UC-Aerospace/Hybrid26_Radio/01 Link Margin/plots/link_margin_heatmap.png

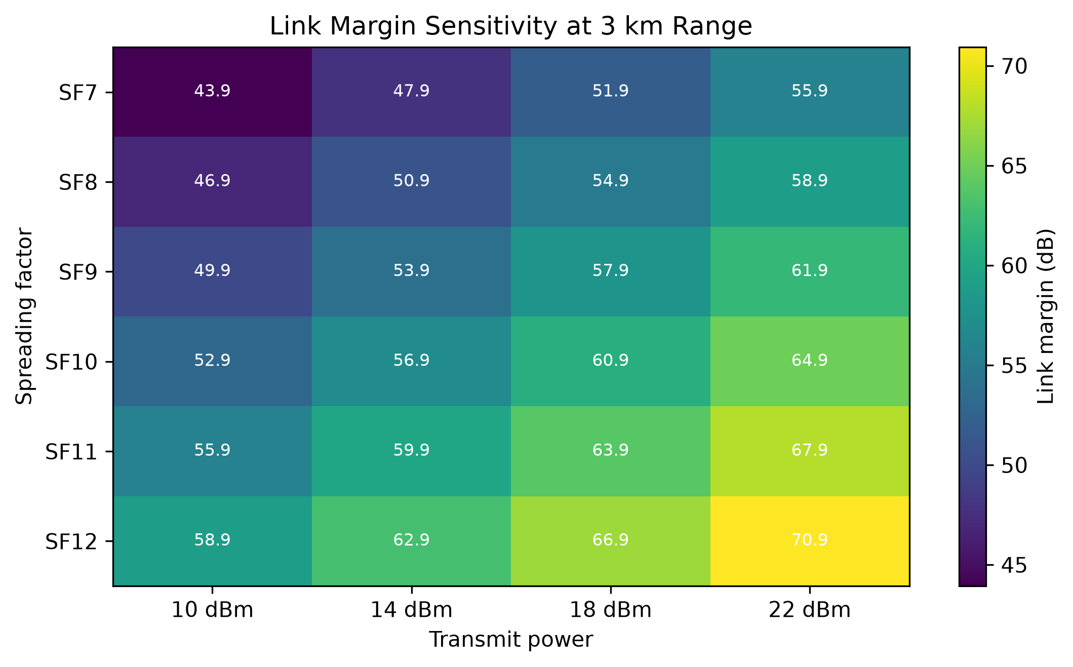
01 Link Margin/plots/link_margin_heatmap.png
