UC-Aerospace/Hybrid26_Radio/01 Link Margin/plots/flight_profile.png

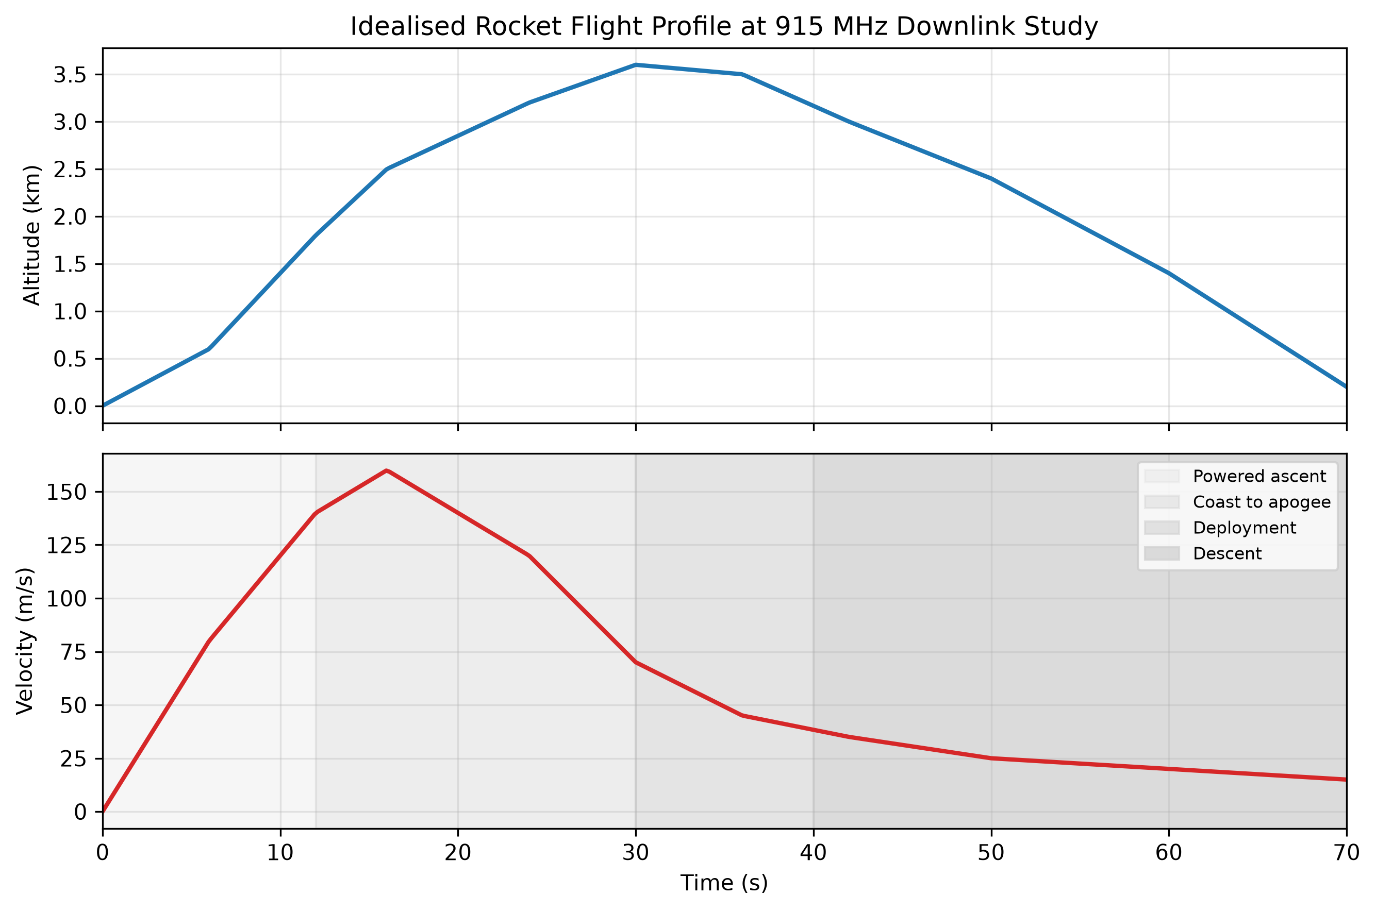
01 Link Margin/plots/flight_profile.png
