UC-Aerospace/Hybrid26_Radio/01 Link Margin/plots/jpole_dimensions.png

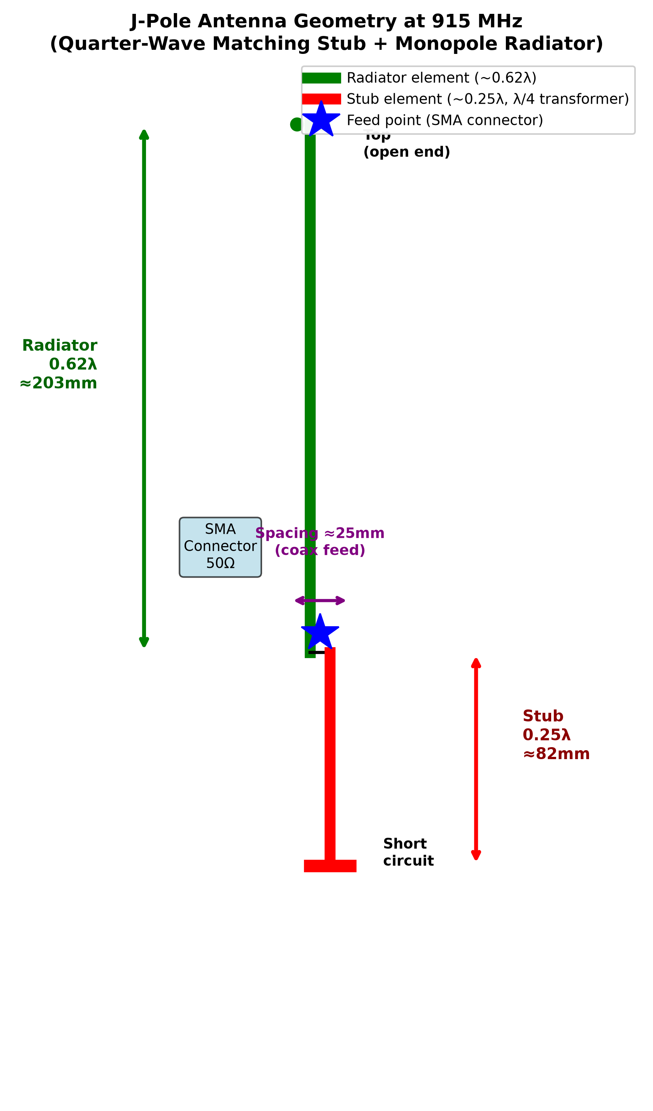
01 Link Margin/plots/jpole_dimensions.png
