UC-Aerospace/Hybrid26_Radio/01 Link Margin/plots/jpole_radiation_pattern.png

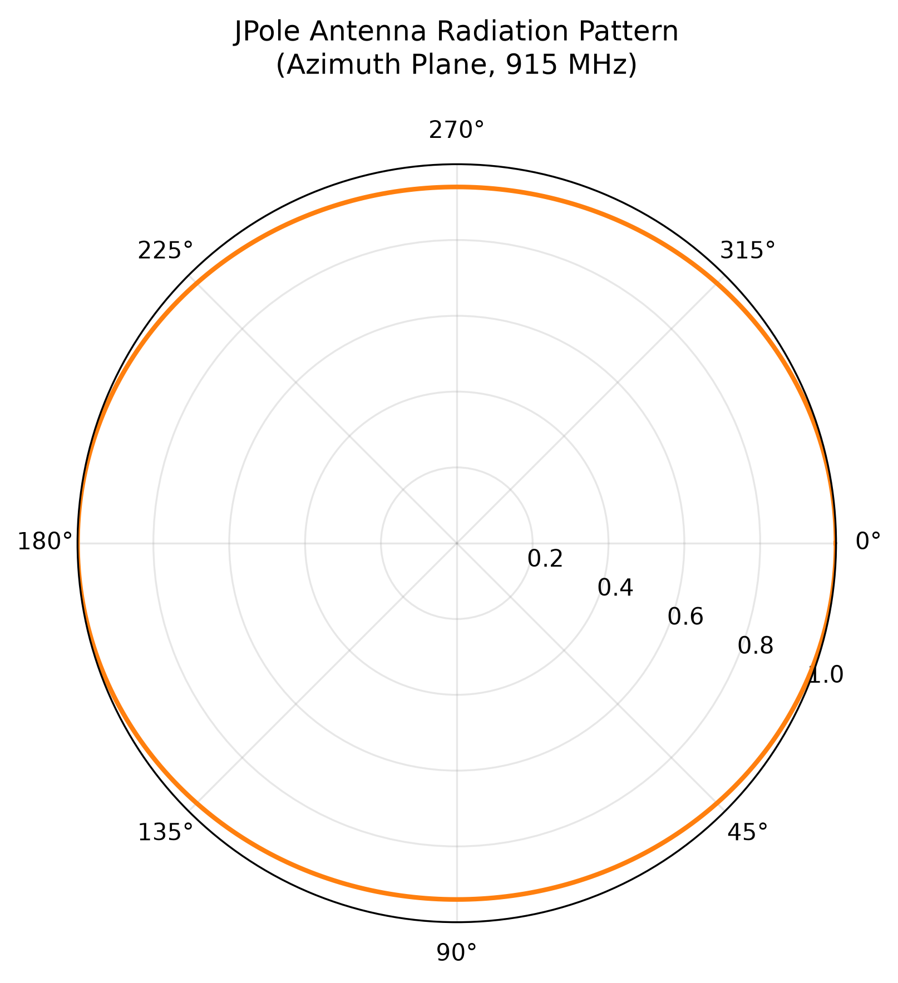
01 Link Margin/plots/jpole_radiation_pattern.png
