UC-Aerospace/Hybrid26_Radio/01 Link Margin/plots/link_margin_vs_range.png

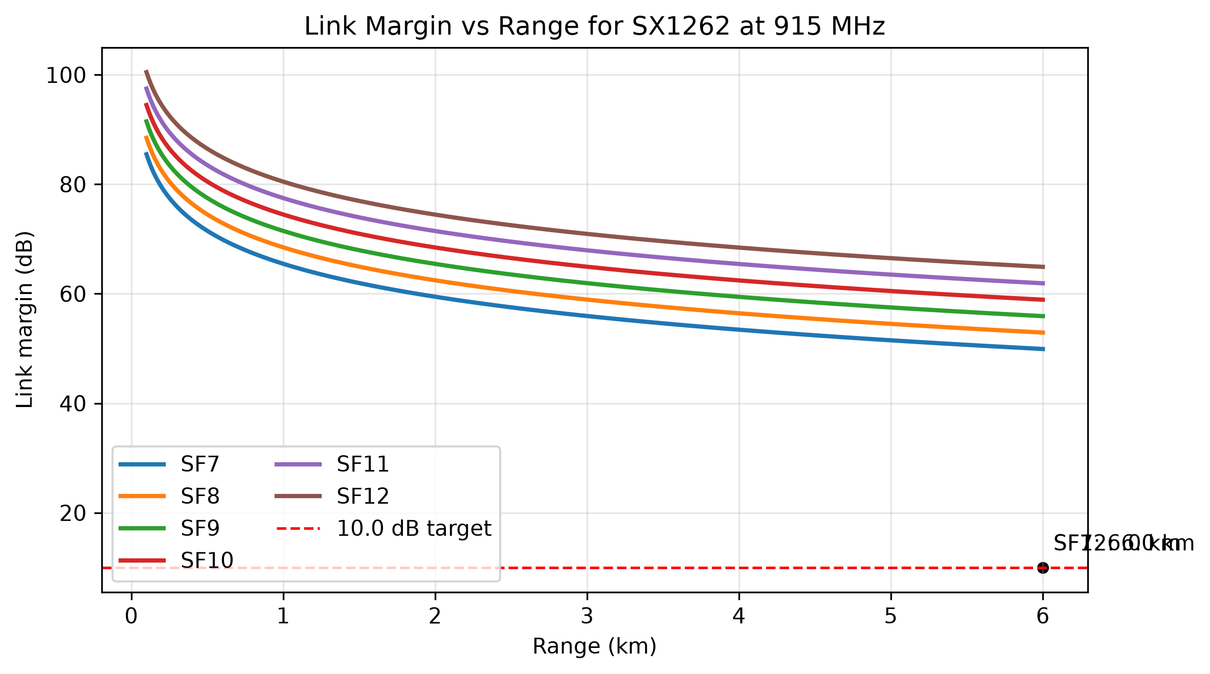
01 Link Margin/plots/link_margin_vs_range.png
