UC-Aerospace/Hybrid26_Radio/01 Link Margin/plots/yagi_layout.png

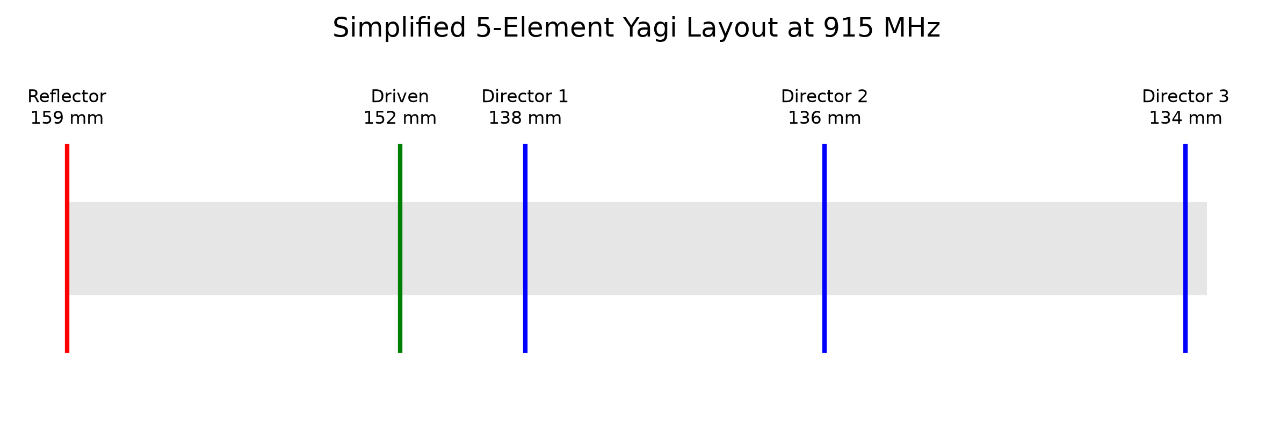
01 Link Margin/plots/yagi_layout.png
