UC-Aerospace/Hybrid26_Radio/01 Link Margin/yagi_element_layout.png

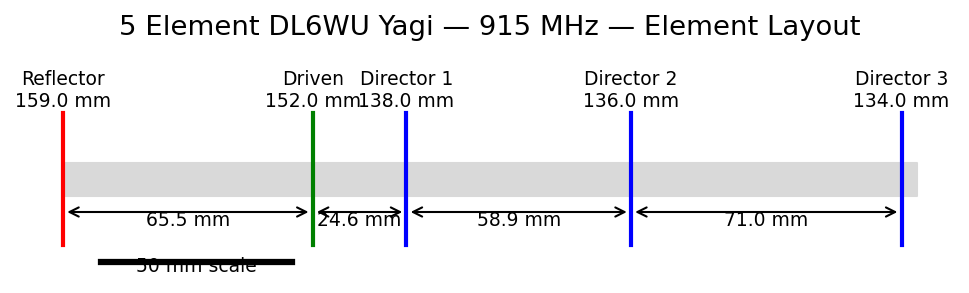
01 Link Margin/yagi_element_layout.png
