UC-Aerospace/Hybrid26_Radio/01 Link Margin/yagi_element_lengths.png

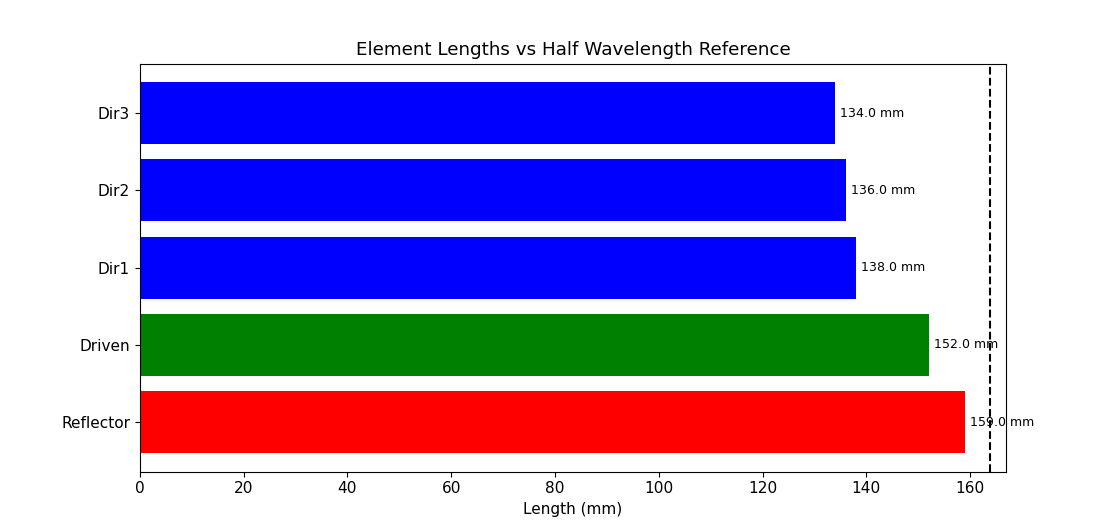
01 Link Margin/yagi_element_lengths.png
