UC-Aerospace/Hybrid26_Radio/01 Link Margin/yagi_link_margin.png

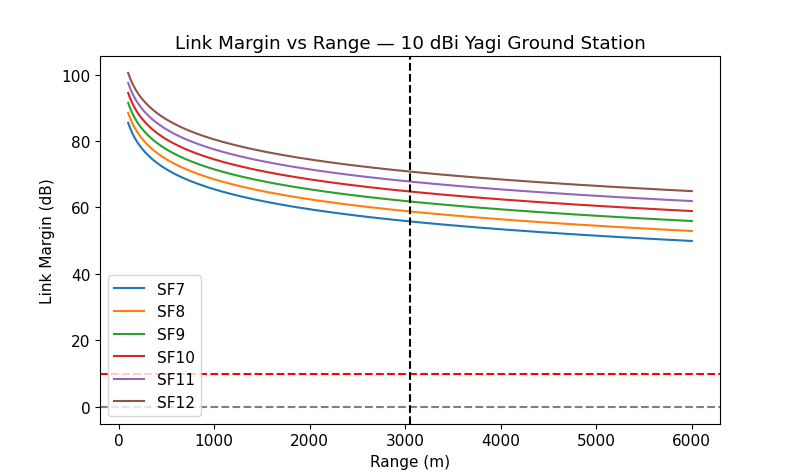
01 Link Margin/yagi_link_margin.png
