UC-Aerospace/Hybrid26_Radio/01 Link Margin/yagi_radiation_pattern.png

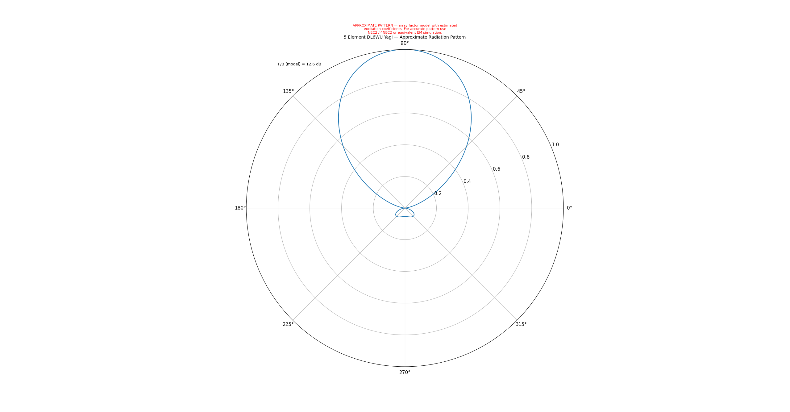
01 Link Margin/yagi_radiation_pattern.png
