UC-Aerospace/Hybrid26_Radio/01 Link Margin/yagi_vswr.png

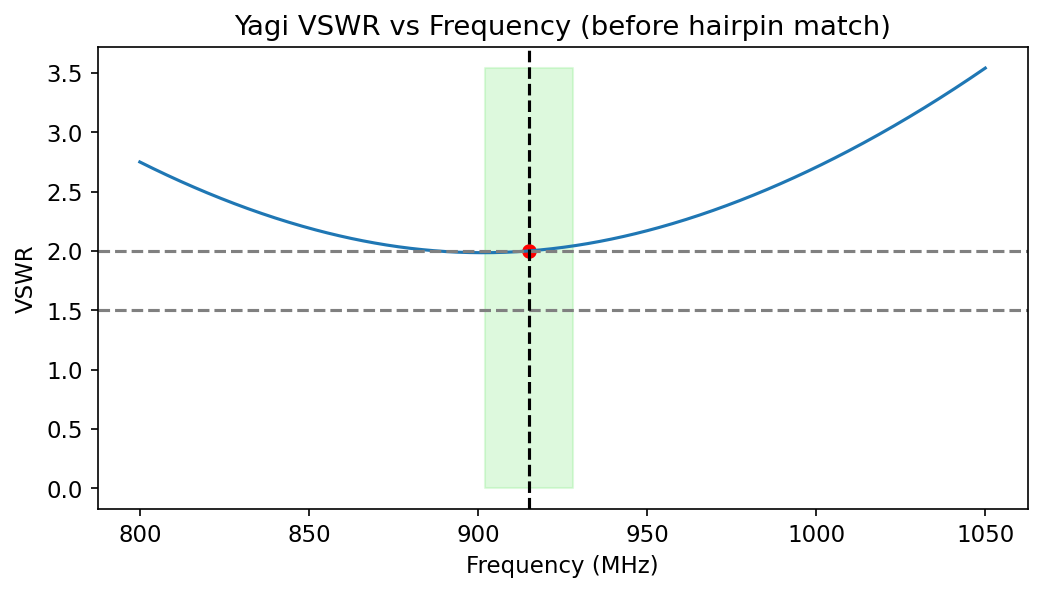
01 Link Margin/yagi_vswr.png
