UC-Aerospace/Hybrid26_Radio/02 Rocket/Antenna/dipole sim 0505/dipole_apogee_margin.png

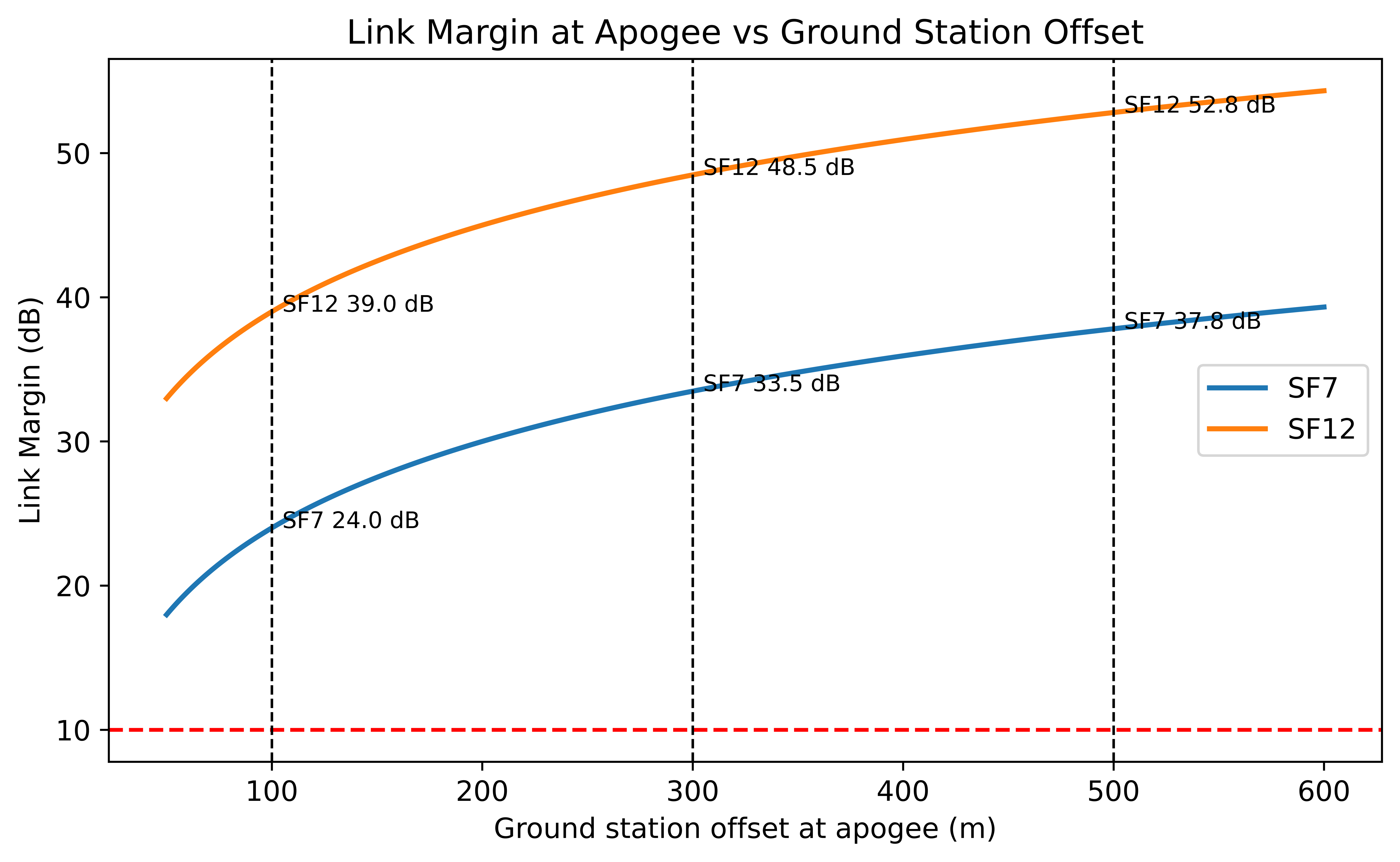
02 Rocket/Antenna/dipole sim 0505/dipole_apogee_margin.png
