UC-Aerospace/Hybrid26_Radio/02 Rocket/Antenna/dipole sim 0505/dipole_gain_vs_elevation_angle.png

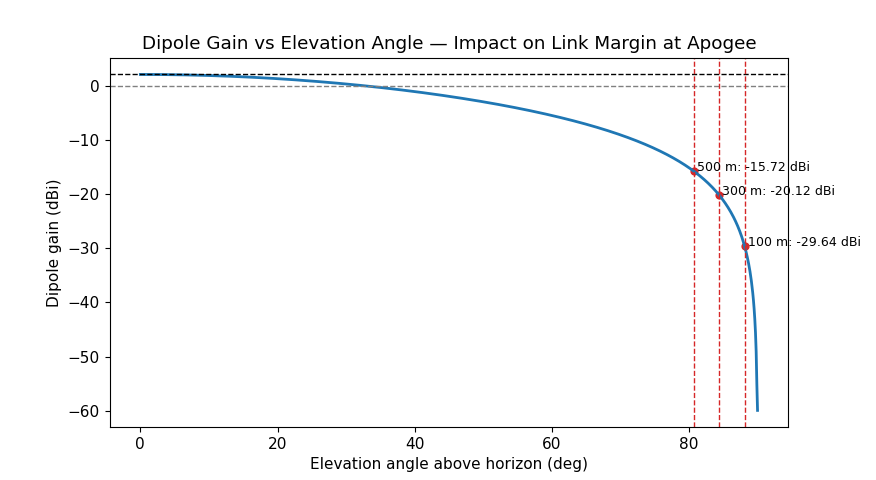
02 Rocket/Antenna/dipole sim 0505/dipole_gain_vs_elevation_angle.png
