UC-Aerospace/Hybrid26_Radio/02 Rocket/Antenna/dipole sim 0505/dipole_radiation_pattern.png

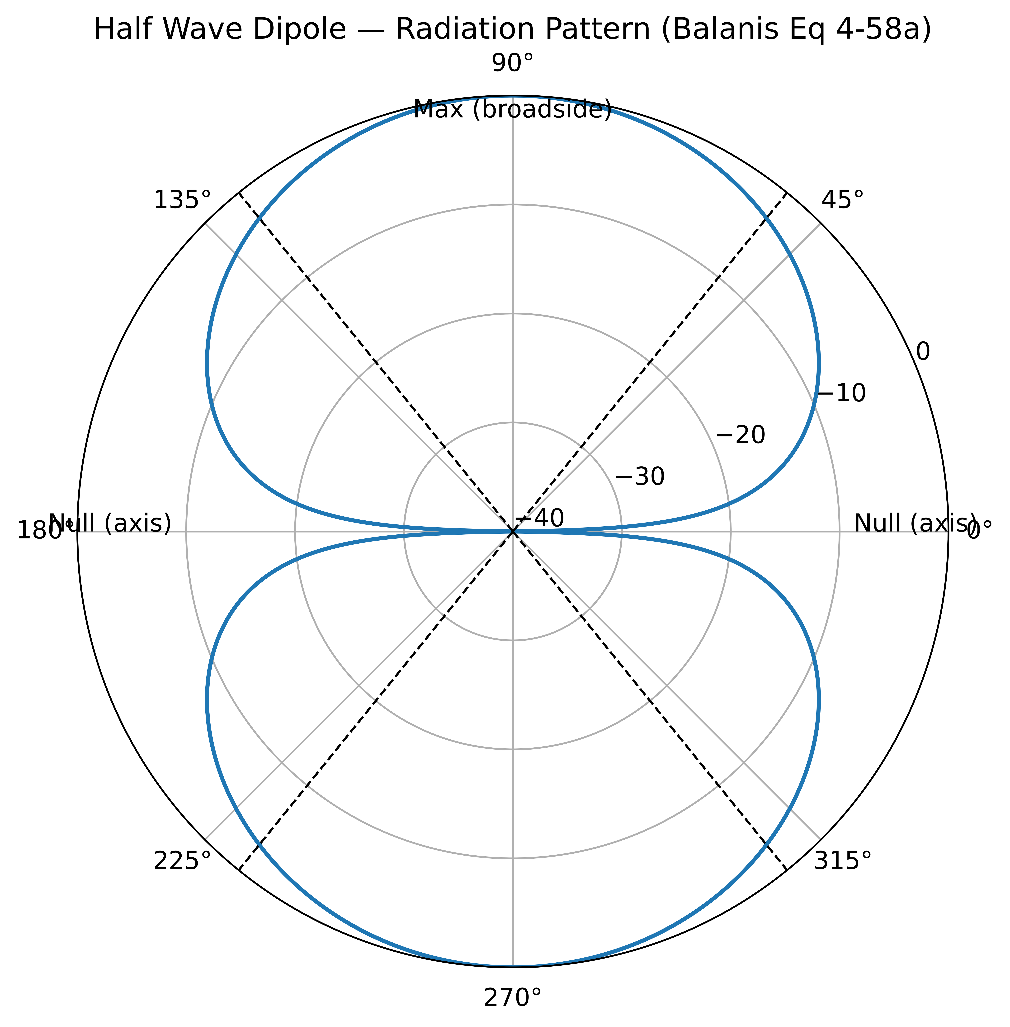
02 Rocket/Antenna/dipole sim 0505/dipole_radiation_pattern.png
