UC-Aerospace/Hybrid26_Radio/02 Rocket/Antenna/dipole sim 0505/half_wave_dipole_radiation_pattern.png

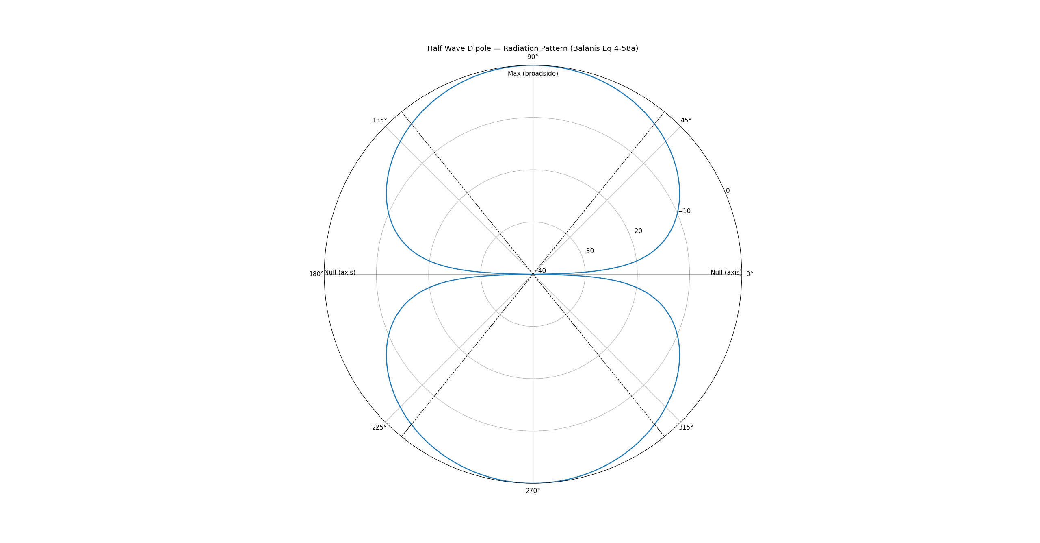
02 Rocket/Antenna/dipole sim 0505/half_wave_dipole_radiation_pattern.png
