UC-Aerospace/Hybrid26_Radio/02 Rocket/Antenna/dipole sim 0505/link_margin_at_apogee_vs_ground_station_offset.png

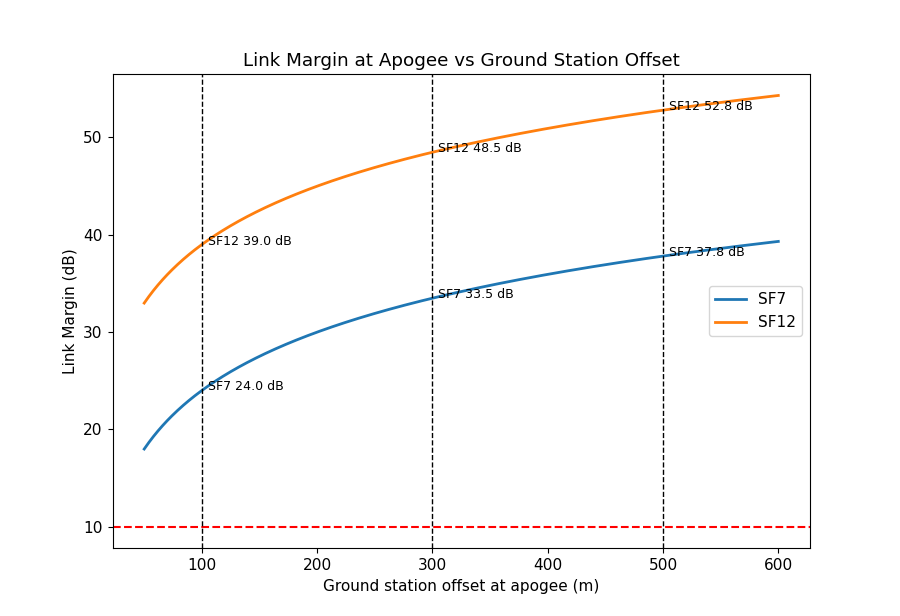
02 Rocket/Antenna/dipole sim 0505/link_margin_at_apogee_vs_ground_station_offset.png
