UC-Aerospace/Hybrid26_Radio/02 Rocket/Antenna/dipole sim 0505/link_margin_vs_range_halfwave_dipole_10dbi_yagi.png

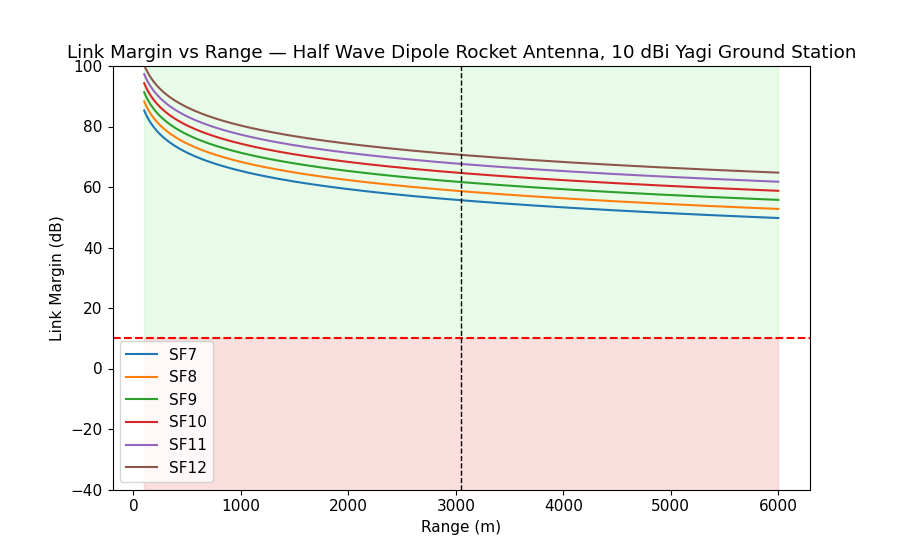
02 Rocket/Antenna/dipole sim 0505/link_margin_vs_range_halfwave_dipole_10dbi_yagi.png
