UC-Aerospace/Hybrid26_Radio/02 Rocket/Antenna/outputs/flight_height_vs_time.png

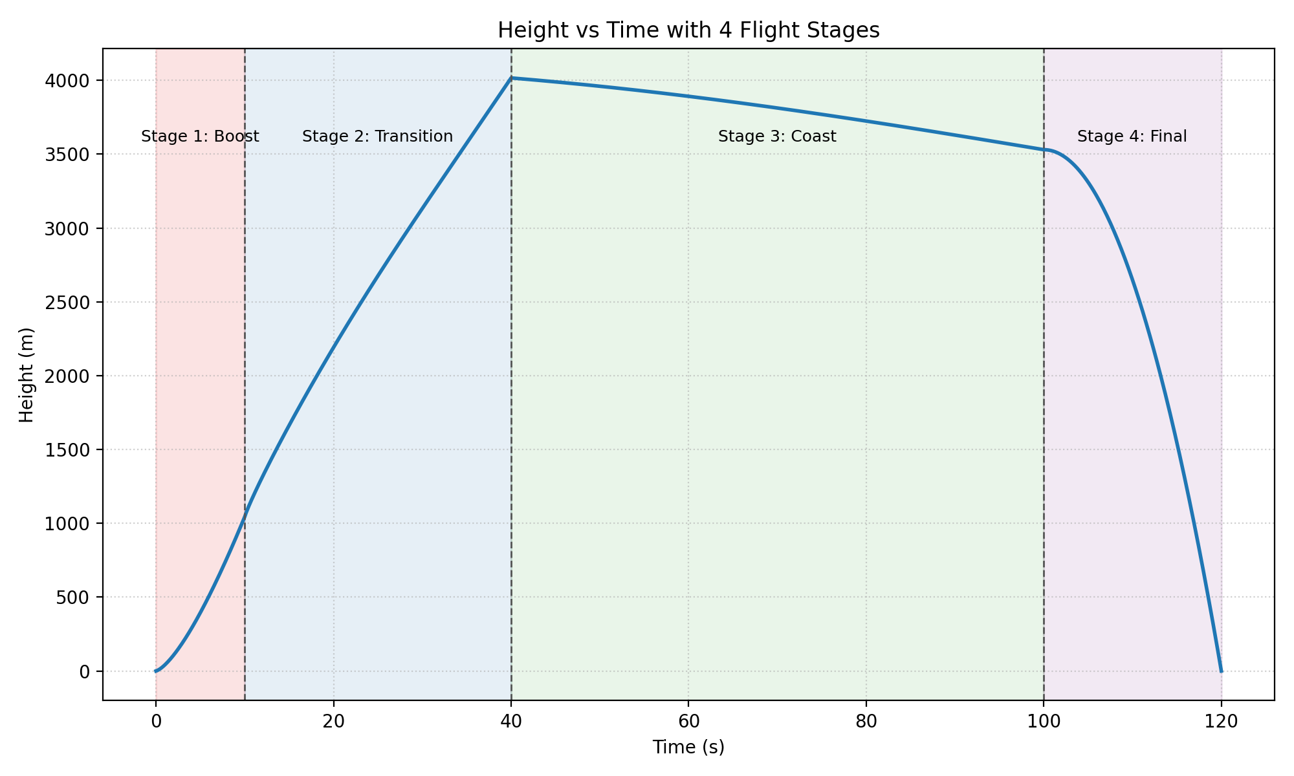
02 Rocket/Antenna/outputs/flight_height_vs_time.png
