UC-Aerospace/Hybrid26_Radio/02 Rocket/Antenna/outputs/flight_path_stages.png

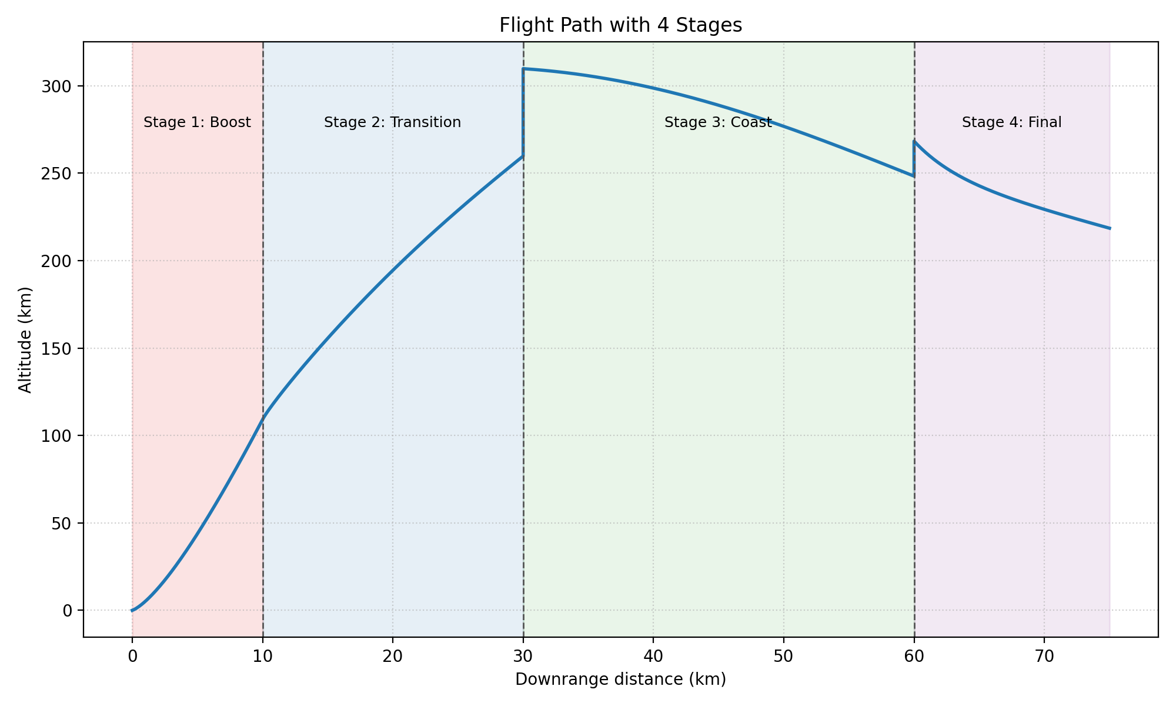
02 Rocket/Antenna/outputs/flight_path_stages.png
