UC-Aerospace/Hybrid26_Radio/02 Rocket/Antenna/outputs/halfwave_dipole_915MHz.png

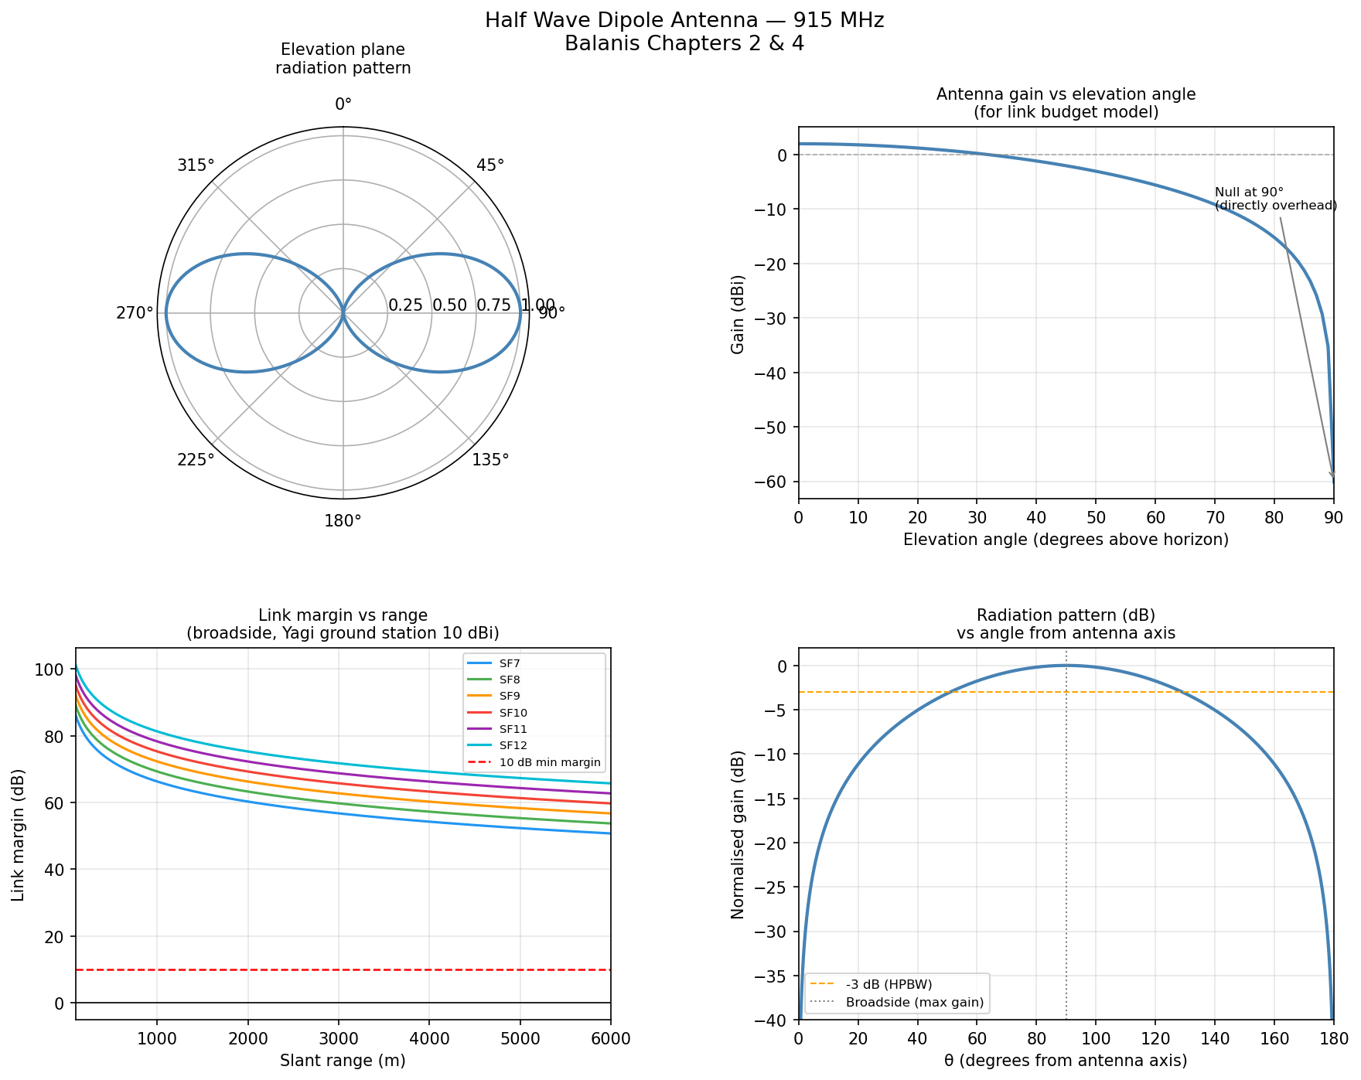
02 Rocket/Antenna/outputs/halfwave_dipole_915MHz.png
