UC-Aerospace/Hybrid26_Radio/02 Rocket/Boards/JPole_Antenna/Screenshot 2026-06-02 153426.png

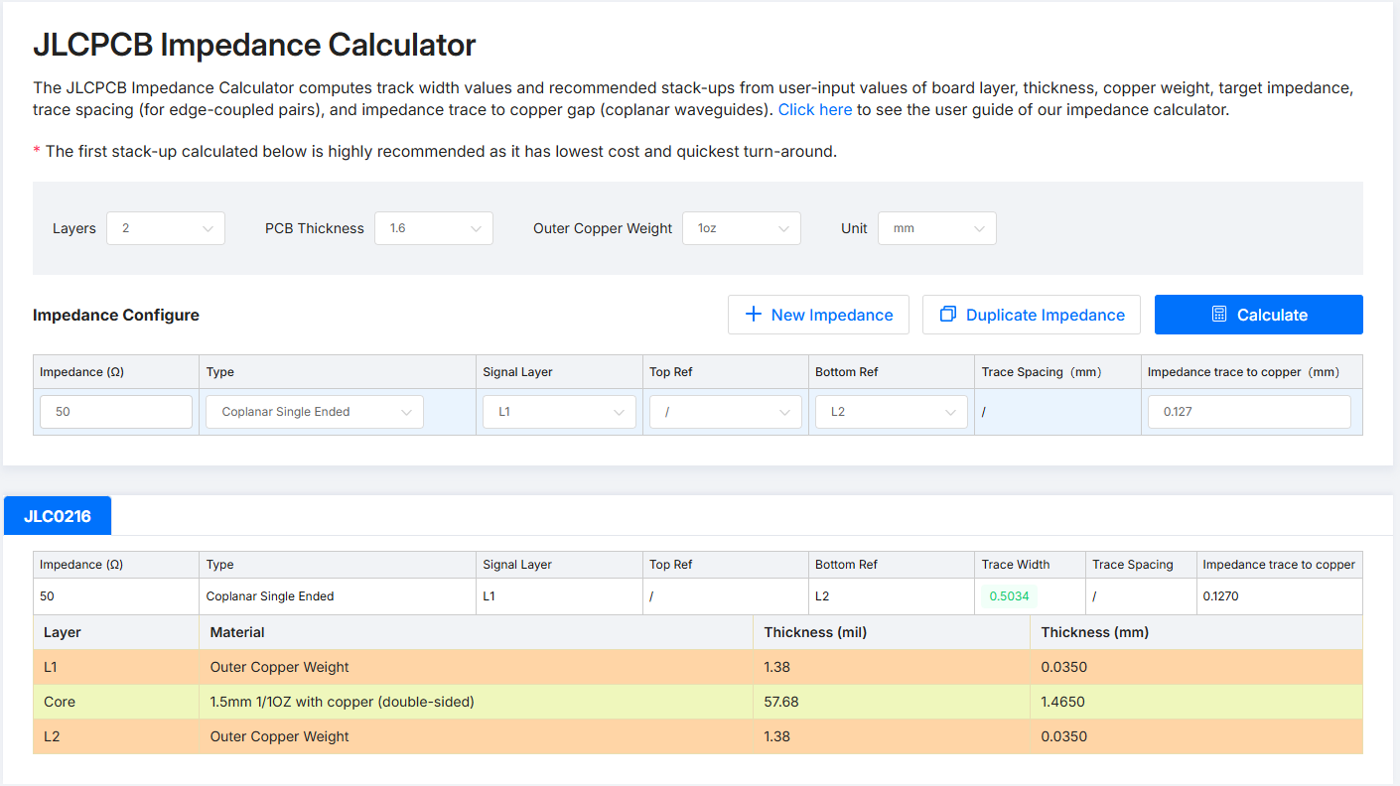
02 Rocket/Boards/JPole_Antenna/Screenshot 2026-06-02 153426.png
