UC-Aerospace/Hybrid26_Radio/02 Rocket/Boards/JPole_Antenna/Screenshot 2026-06-18 105022.png

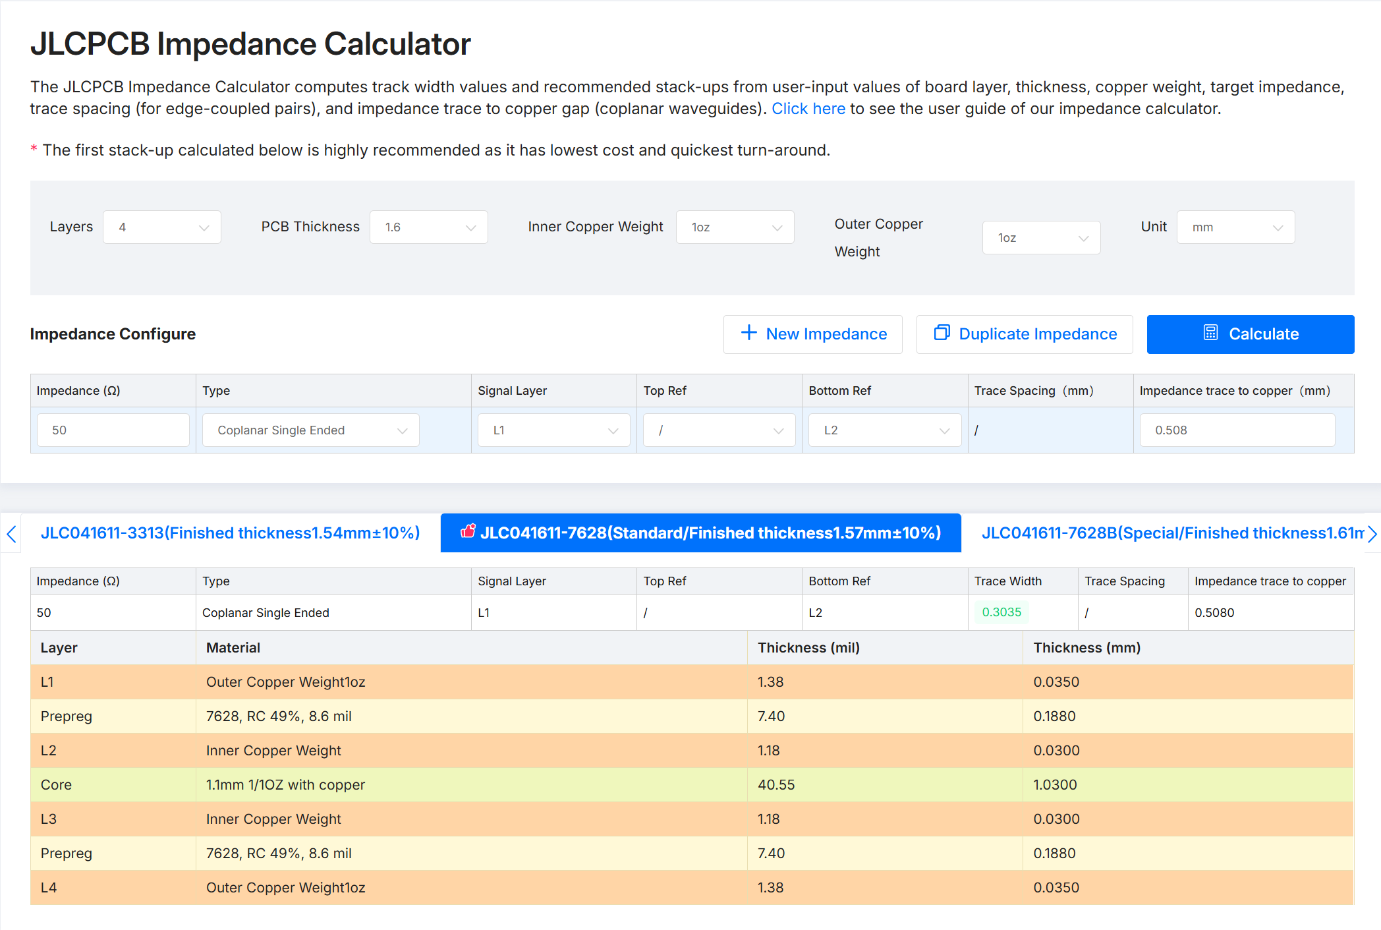
02 Rocket/Boards/JPole_Antenna/Screenshot 2026-06-18 105022.png
