UC-Aerospace/Hybrid26_Radio/02 Rocket/Boards/Onboard_Radio/Screenshot 2026-06-22 130152.png

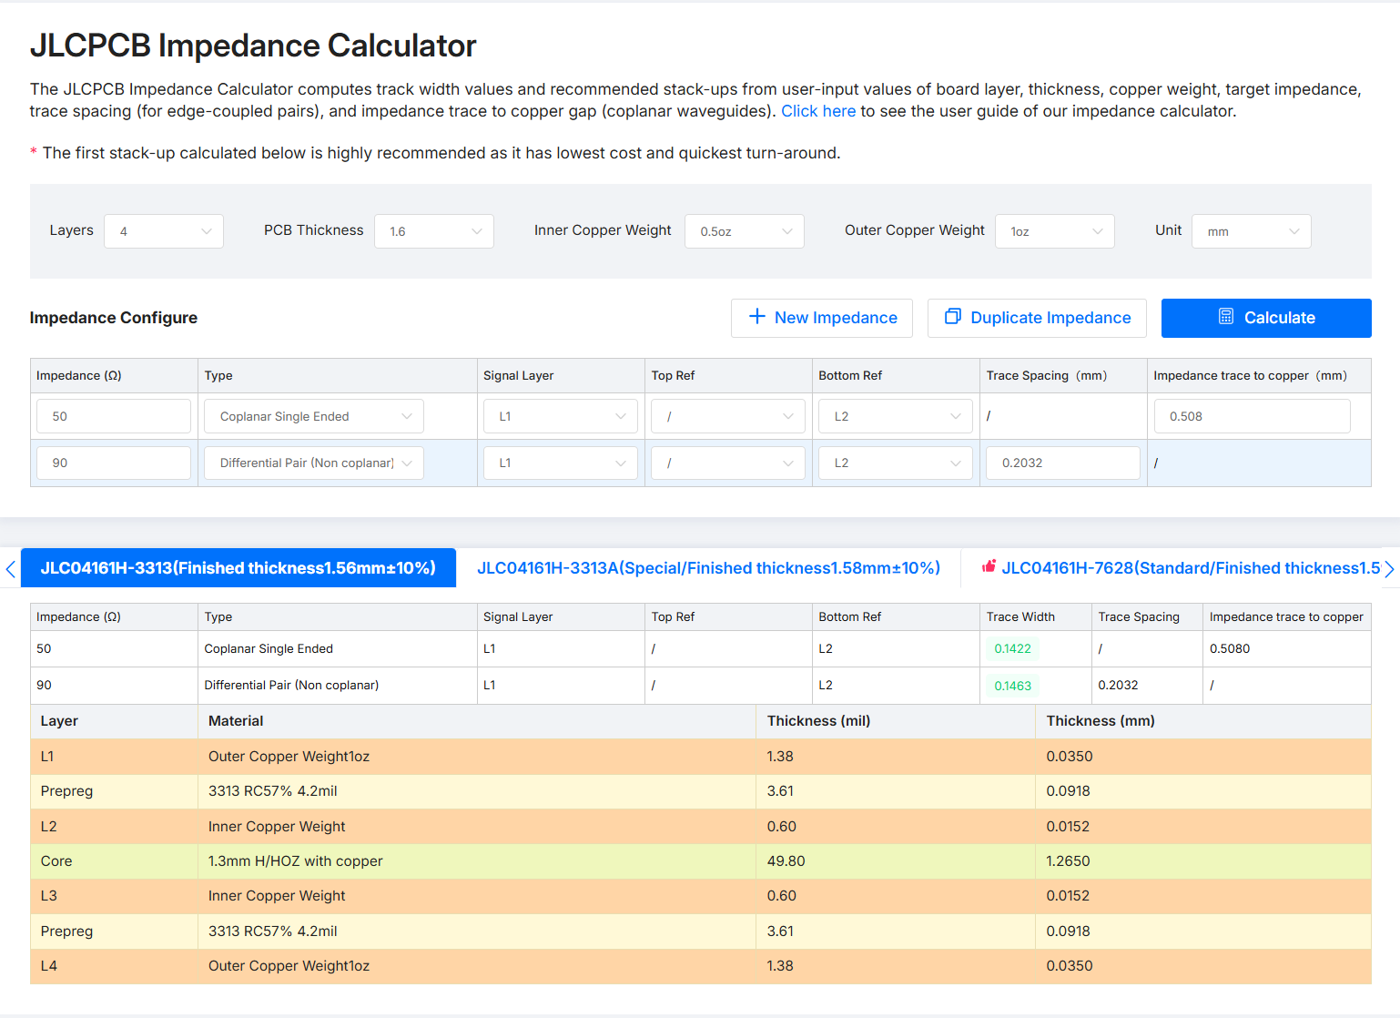
02 Rocket/Boards/Onboard_Radio/Screenshot 2026-06-22 130152.png
