UC-Aerospace/Hybrid26_Radio/03 Ground Station/Yagi Antenna/Yagi Simulation/yagi_element_lengths.png

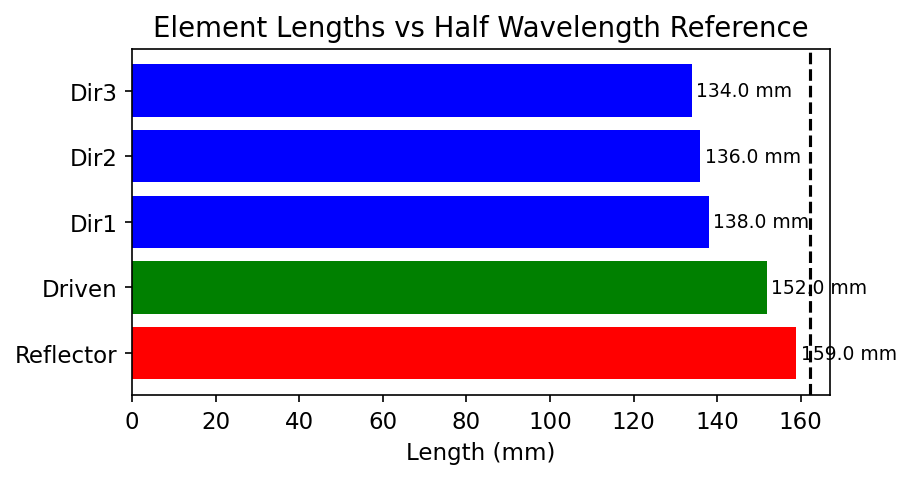
03 Ground Station/Yagi Antenna/Yagi Simulation/yagi_element_lengths.png
