UC-Aerospace/Hybrid26_Radio/03 Ground Station/Yagi Antenna/Yagi Simulation/yagi_link_margin.png

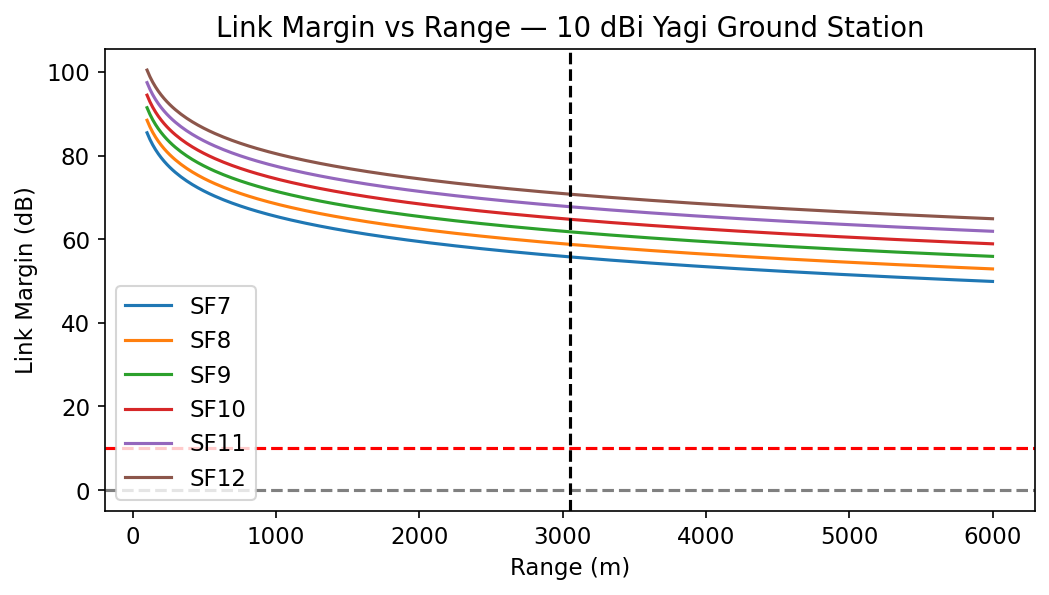
03 Ground Station/Yagi Antenna/Yagi Simulation/yagi_link_margin.png
