UC-Aerospace/Hybrid26_Radio/03 Ground Station/Yagi Antenna/Yagi Simulation/yagi_radiation_pattern.png

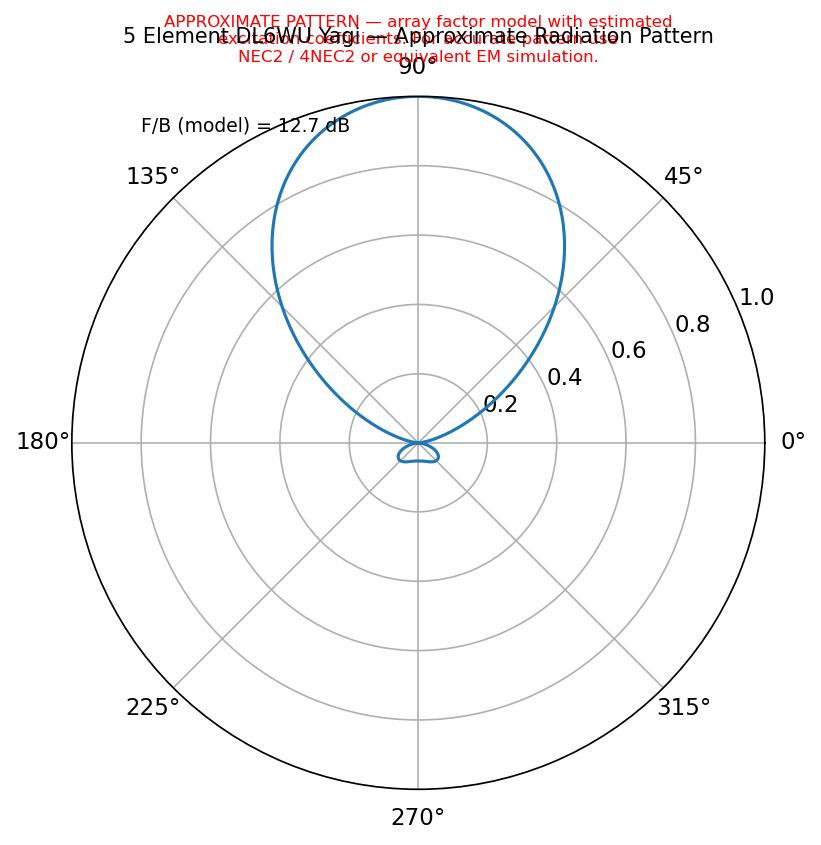
03 Ground Station/Yagi Antenna/Yagi Simulation/yagi_radiation_pattern.png
