UC-Aerospace/Hybrid26_Radio/02 Rocket/Boards/JPole_Antenna/production/bom.csv

Designator | Footprint | Quantity | Value | LCSC Part #
J1 | SMA-KE-16.5A_EdgeMount (1) | 1 | Conn_Coaxial
T1 | NCS1-112+ | 1 | NCS1-112+
