UC-Aerospace/Hybrid26_Radio/02 Rocket/Boards/JPole_Antenna/jpoleboard.step

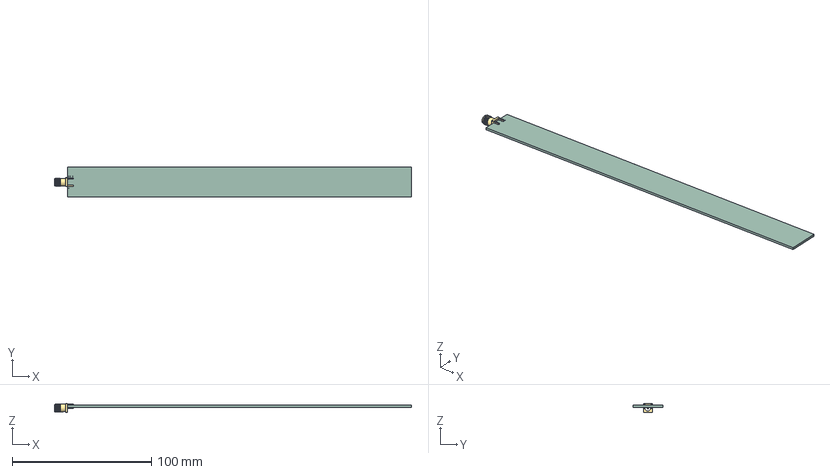
[picture p31: CAD file, 2026-06-19]
02 Rocket/Boards/JPole_Antenna/jpoleboard.step
256.1 x 21.5 x 6.50 mm
Dielectric
Pin
JPole_Antenna_PCB
