UC-Aerospace/Hybrid26_Radio/02 Rocket/Antenna/dipole sim 0505/dipole_assembly.png

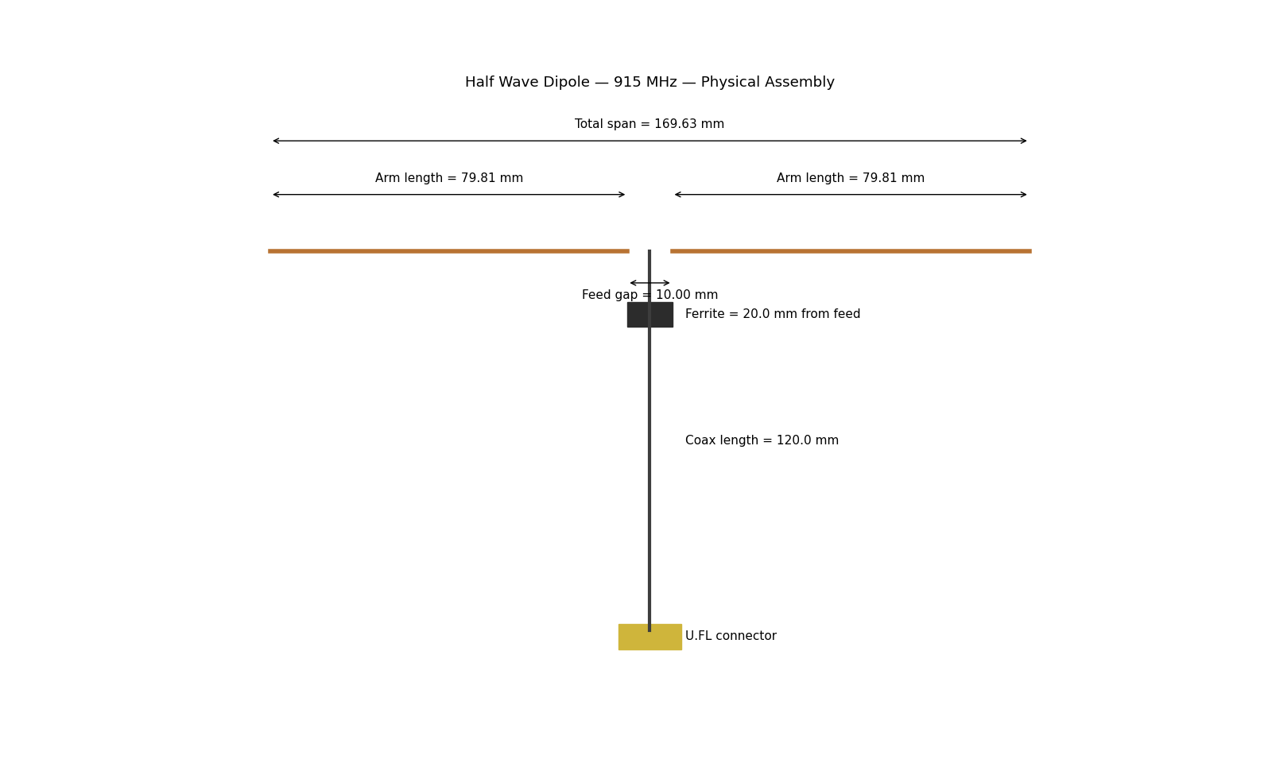
02 Rocket/Antenna/dipole sim 0505/dipole_assembly.png
