UC-Aerospace/Hybrid26_Radio/02 Rocket/Boards/Onboard_Radio/rf_rocket_module.pdf

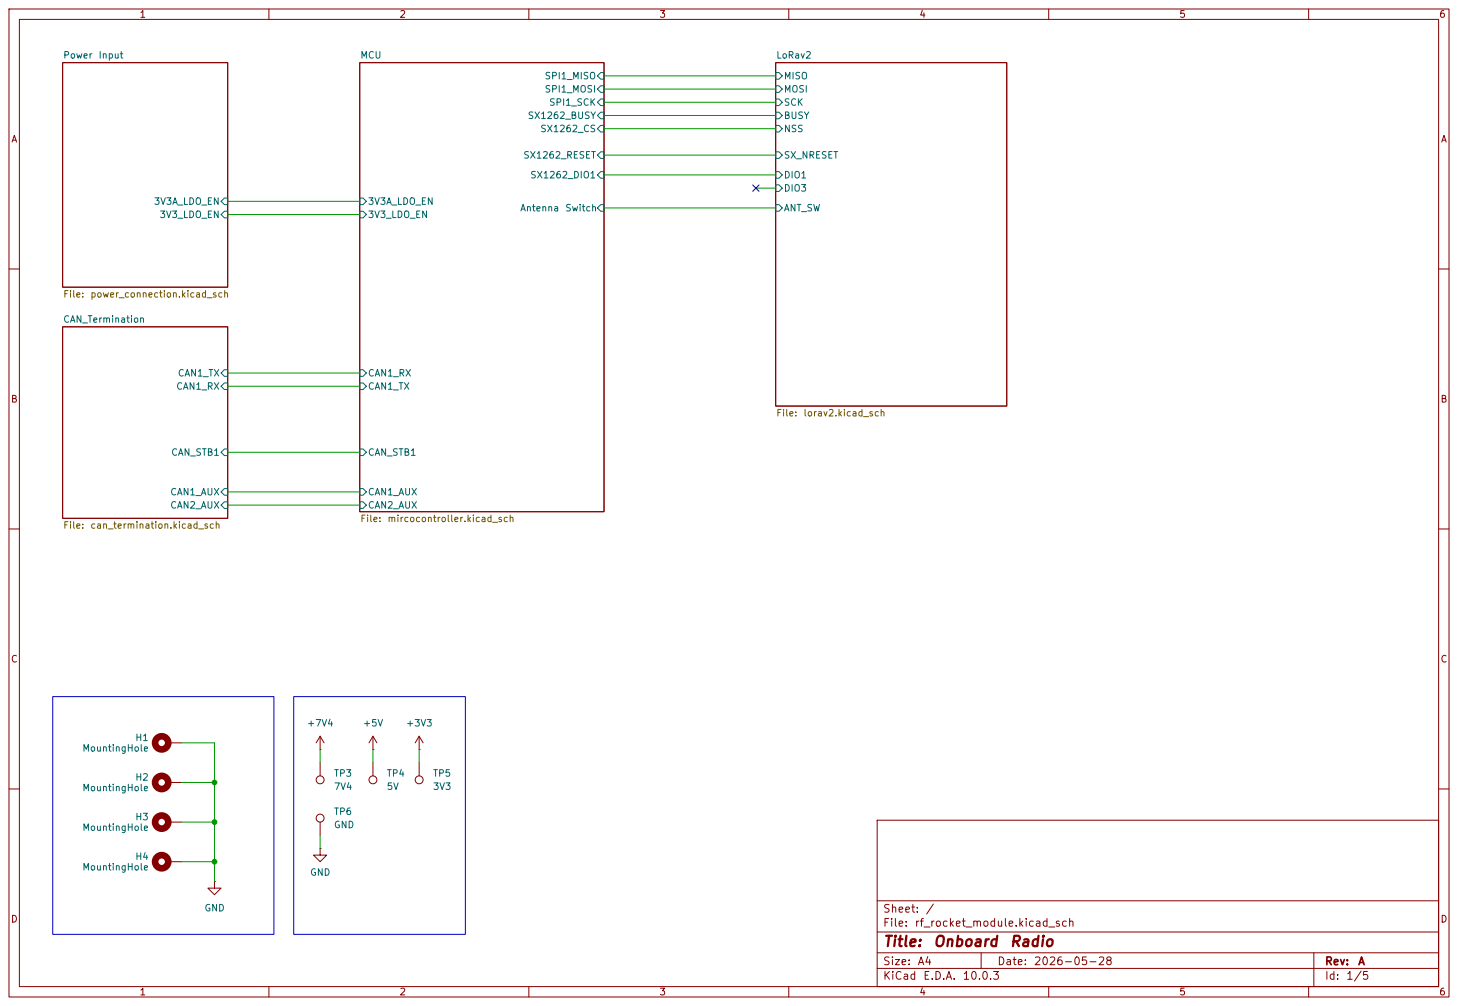
[picture p33: page 1]

Size: A4 | Rev: A
KiCad E.D.A. 10.0.3 | Id: 1/5

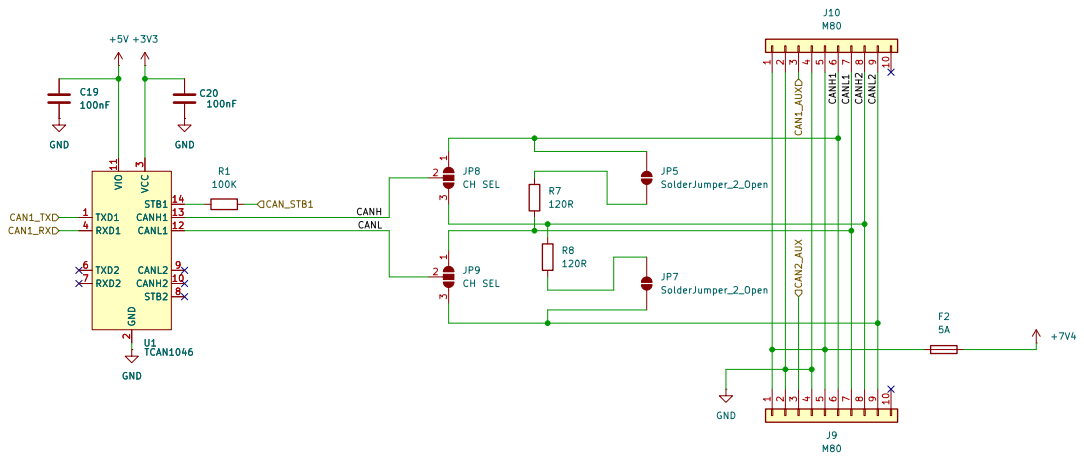
[picture p34: page 2]

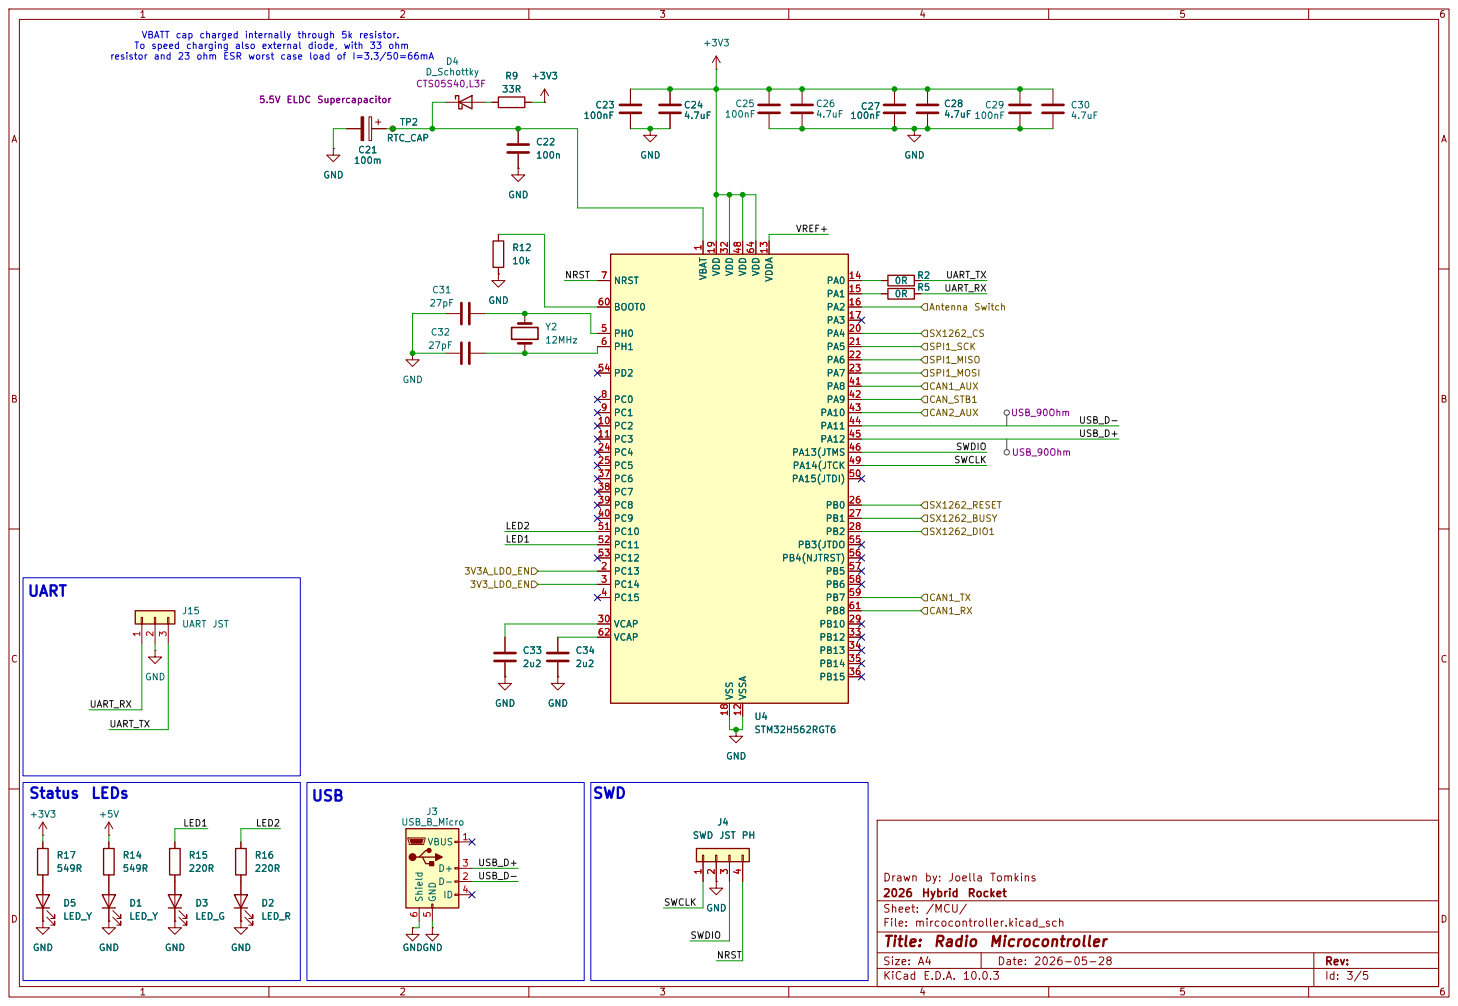
[picture p35: page 3]

VBATT cap charged internally through 5k resistor. To speed charging also external diode, with 33 ohm
100nF GND

resistor and 23 ohm ESR worst case load of I=3.3/50=66mA

Drawn by: Joella Tomkins
2026 Hybrid Rocket
Sheet: /MCU/
File: mircocontroller.kicad_sch
Title: Radio Microcontroller

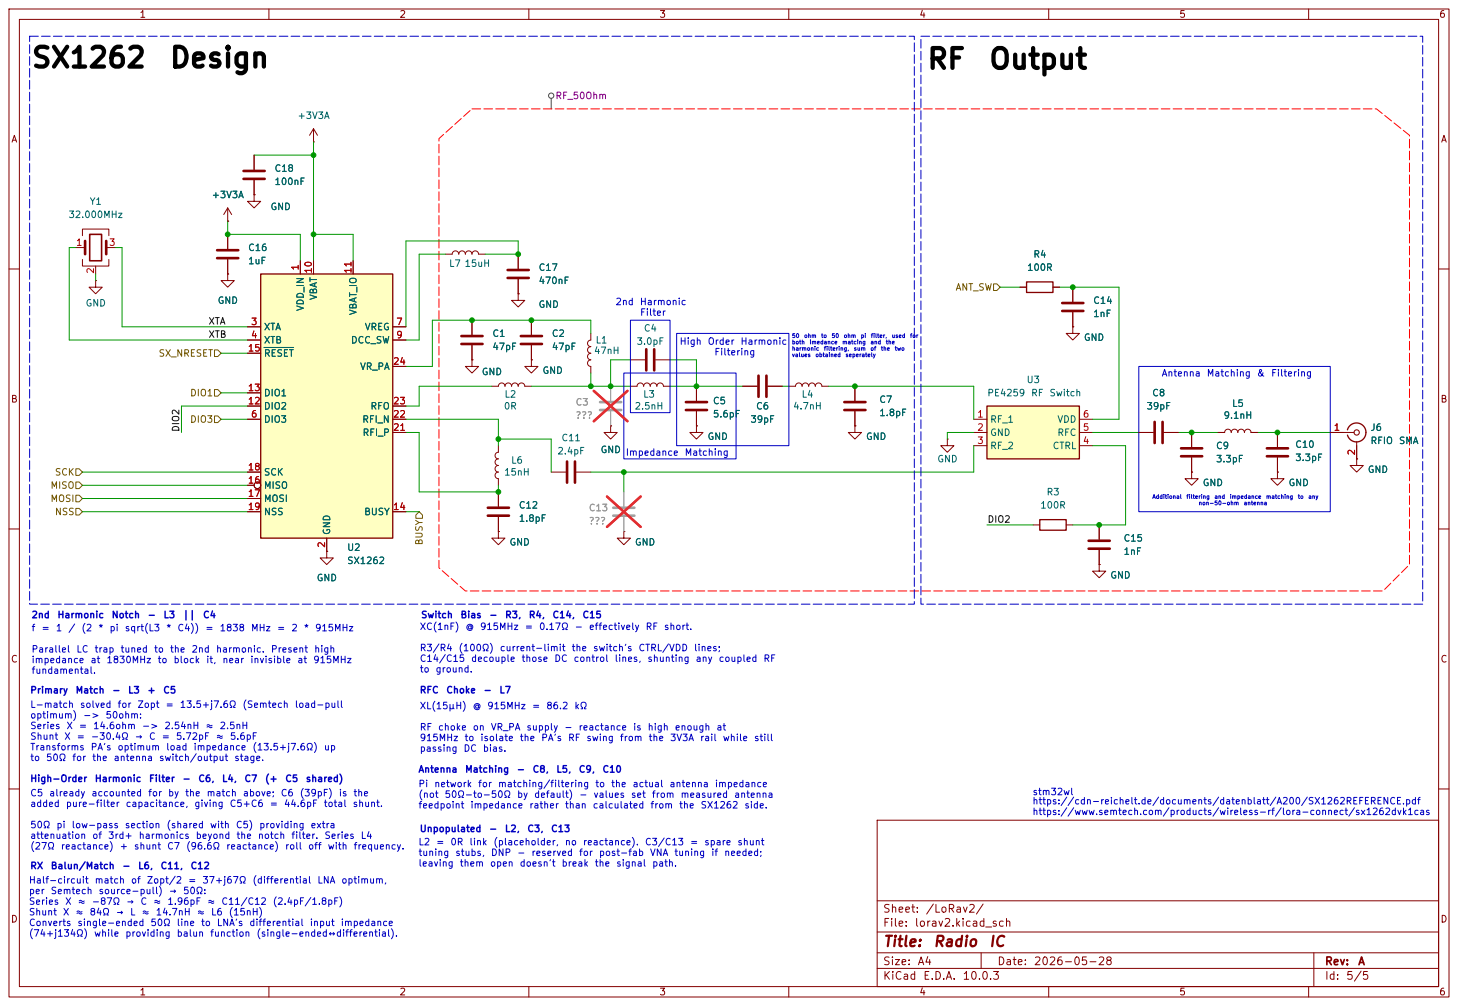
[picture p36: page 4]

feedpoint impedance rather than calculated from the SX1262 side. High Order Harmonic Filtering

50 ohm to 50 ohm pi filter, used for both imedance matcing and the harmonic filtering, sum of the two

values obtained seperately Primary Match - L3 + C5 High-Order Harmonic Filter - C6, L4, C7 (+ C5 shared) RX Balun/Match - L6, C11, C12

(74+j134Ω) while providing balun function (single-ended↔differential). 2nd Harmonic Notch - L3 || C4
f = 1 / (2 * pi sqrt(L3 * C4)) = 1838 MHz = 2 * 915MHz Parallel LC trap tuned to the 2nd harmonic. Present high

leaving them open doesn't break the signal path. Switch Bias - R3, R4, C14, C15
RF choke on VR_PA supply - reactance is high enough at 915MHz to isolate the PA's RF swing from the 3V3A rail while still passing DC bias. XC(1nF) @ 915MHz = 0.17Ω - effectively RF short. R3/R4 (100Ω) current-limit the switch's CTRL/VDD lines;

impedance at 1830MHz to block it, near invisible at 915MHz
fundamental. C5 already accounted for by the match above; C6 (39pF) is the added pure-filter capacitance, giving C5+C6 = 44.6pF total shunt. 50Ω pi low-pass section (shared with C5) providing extra attenuation of 3rd+ harmonics beyond the notch filter. Series L4

C14/C15 decouple those DC control lines, shunting any coupled RF
to ground. L2 = 0R link (placeholder, no reactance). C3/C13 = spare shunt
Antenna Matching - C8, L5, C9, C10 Unpopulated - L2, C3, C13 RFC Choke - L7
XL(15µH) @ 915MHz = 86.2 kΩ

L-match solved for Zopt = 13.5+j7.6Ω (Semtech load-pull
optimum) -> 50ohm: Series X = 14.6ohm -> 2.54nH ≈ 2.5nH

Shunt X = -30.4Ω → C = 5.72pF ≈ 5.6pF
Transforms PA's optimum load impedance (13.5+j7.6Ω) up
to 50Ω for the antenna switch/output stage. Half-circuit match of Zopt/2 = 37+j67Ω (differential LNA optimum, per Semtech source-pull) → 50Ω: Series X ≈ −87Ω → C ≈ 1.96pF ≈ C11/C12 (2.4pF/1.8pF) Shunt X ≈ 84Ω → L ≈ 14.7nH ≈ L6 (15nH) Converts single-ended 50Ω line to LNA's differential input impedance

Pi network for matching/filtering to the actual antenna impedance
(not 50Ω-to-50Ω by default) - values set from measured antenna

stm32wl https://cdn-reichelt.de/documents/datenblatt/A200/SX1262REFERENCE.pdf
https://www.semtech.com/products/wireless-rf/lora-connect/sx1262dvk1cas

(27Ω reactance) + shunt C7 (96.6Ω reactance) roll off with frequency.

tuning stubs, DNP - reserved for post-fab VNA tuning if needed;

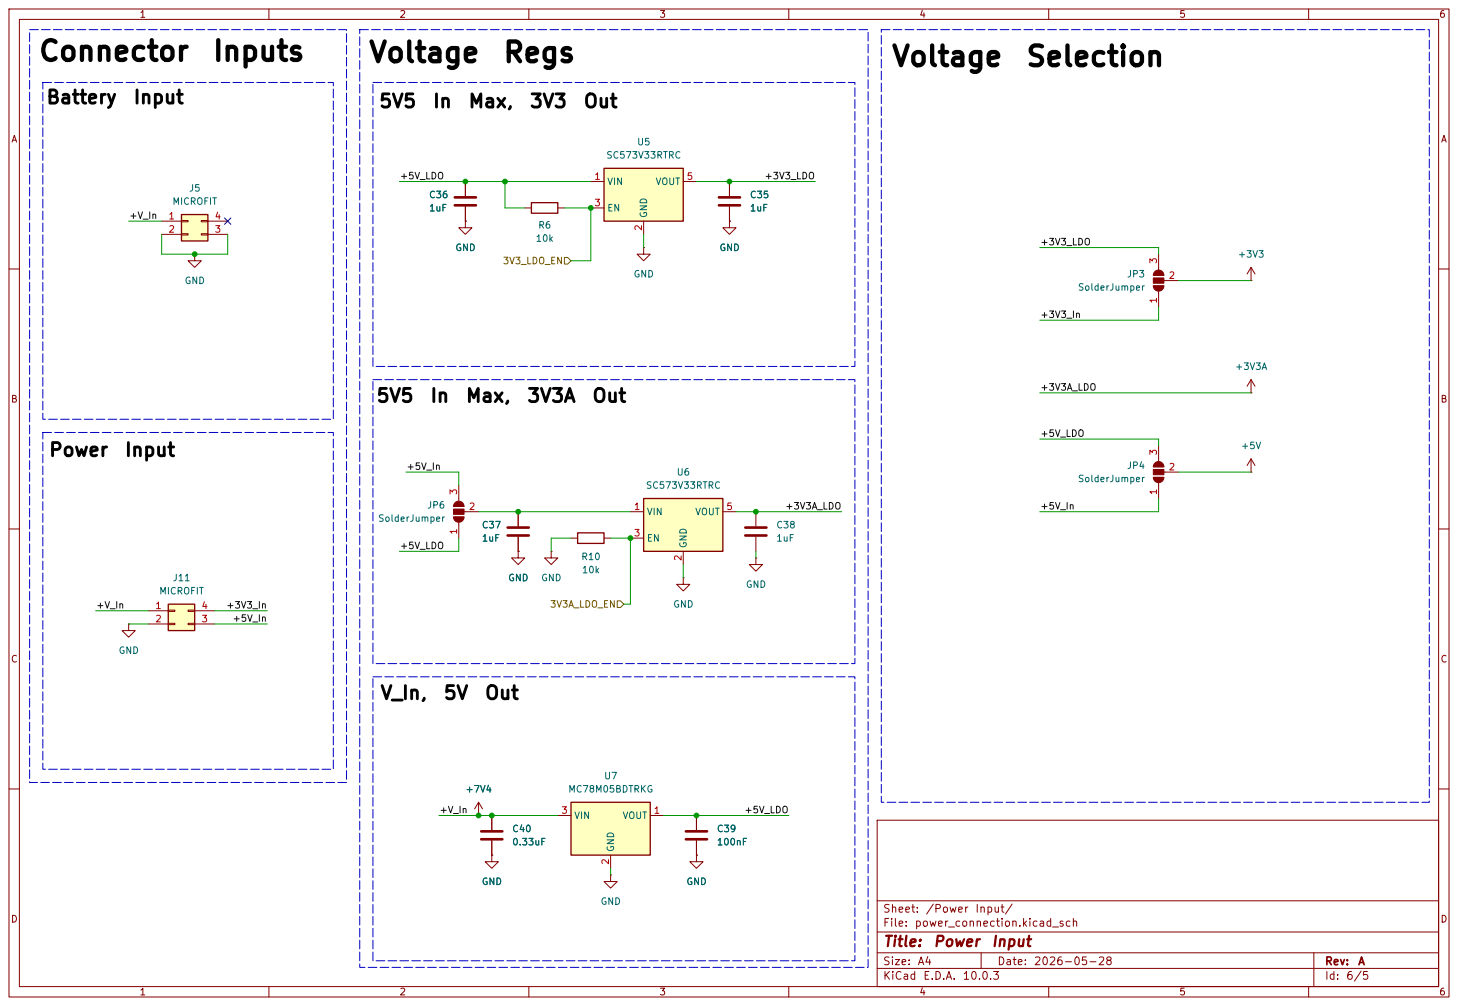
[picture p37: page 5]
