UC-Aerospace/Hybrid26_Radio/02 Rocket/Boards/Onboard_Radio/schematic_pdf.pdf

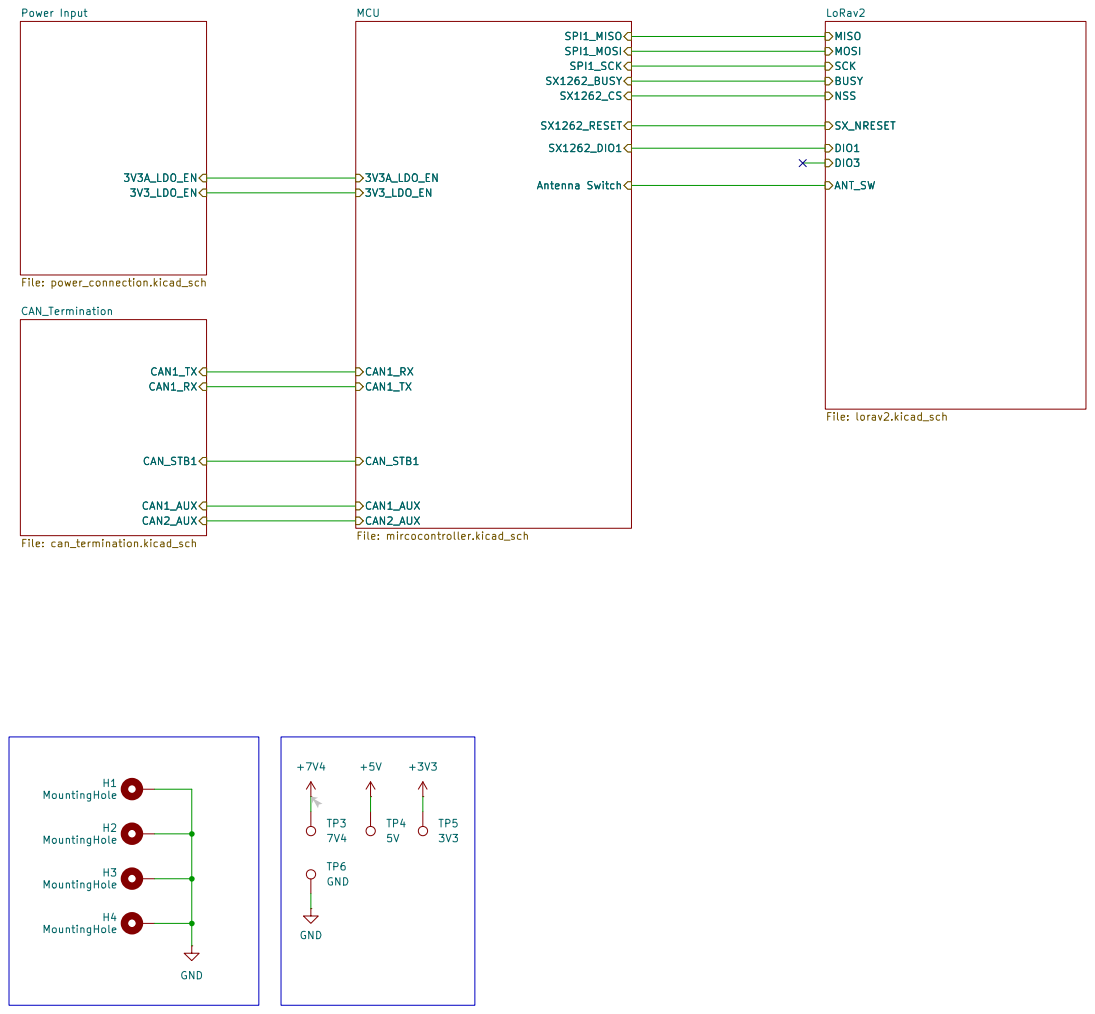
[picture p38: page 1]

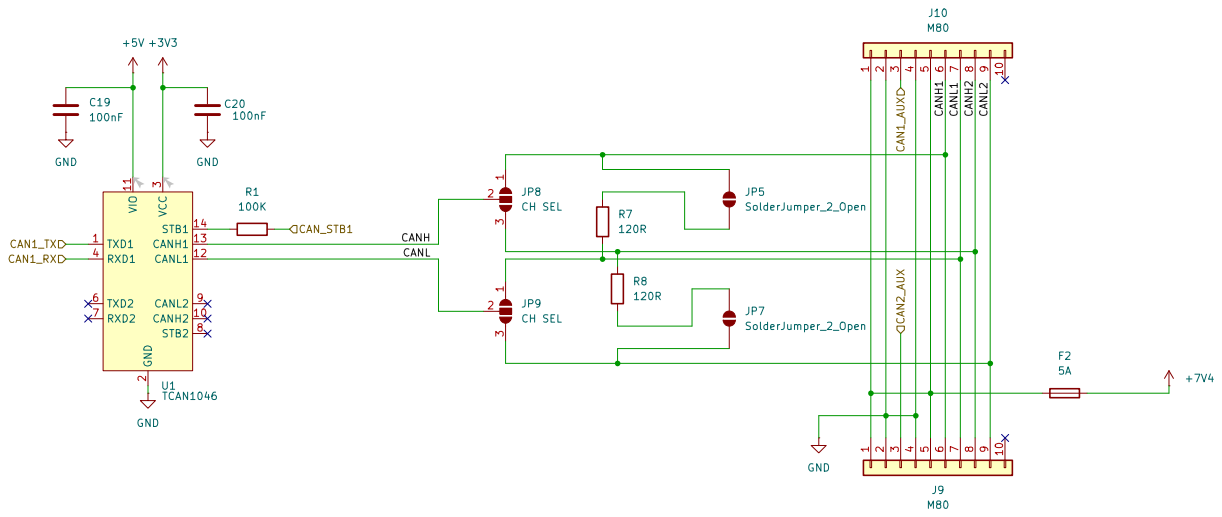
[picture p39: page 2]

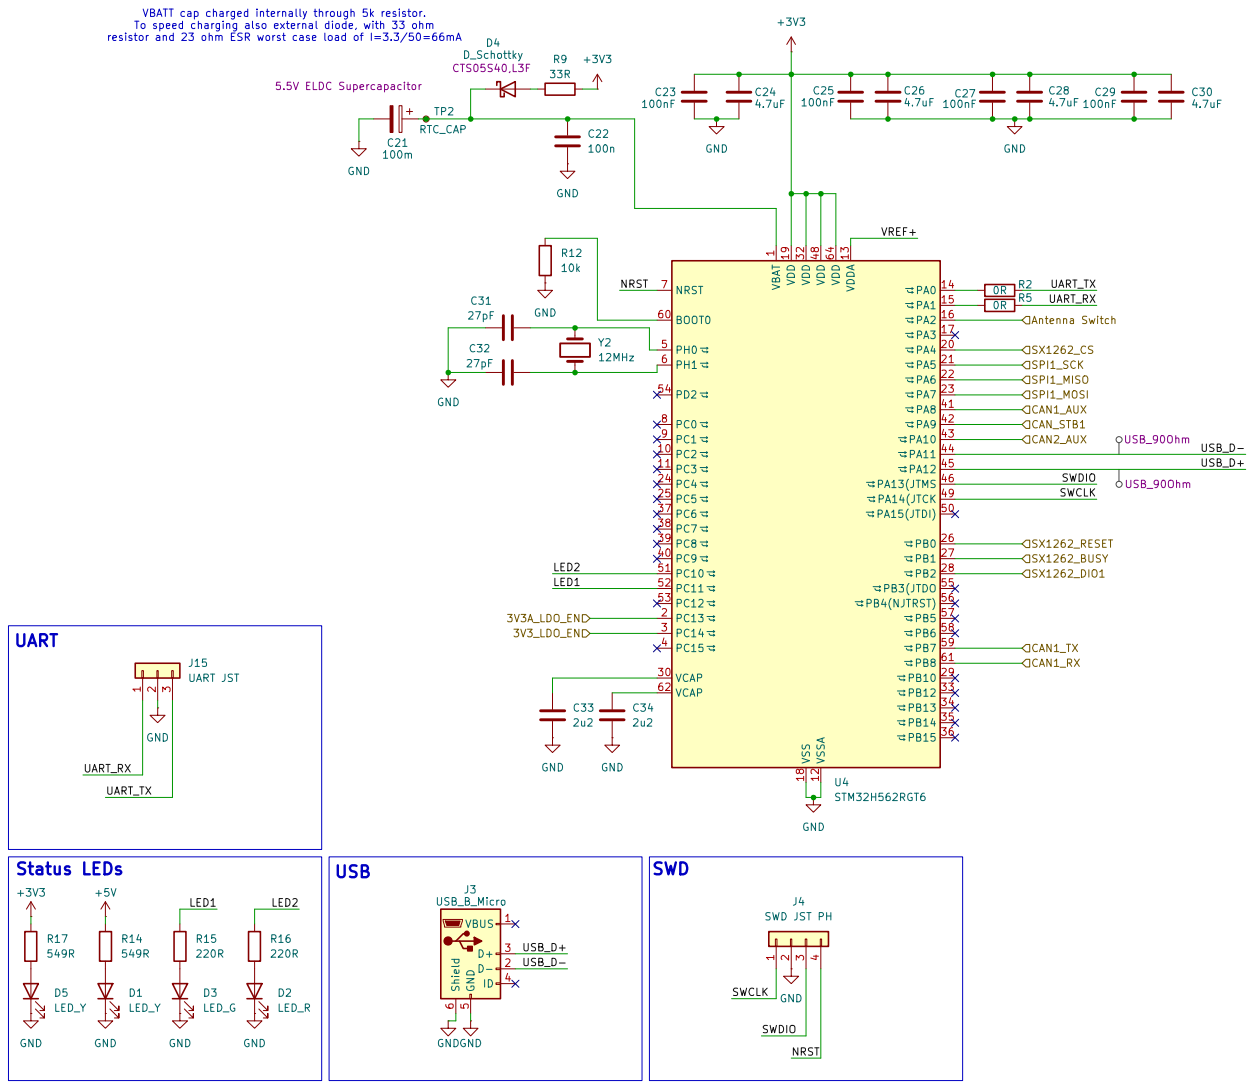
[picture p40: page 3]

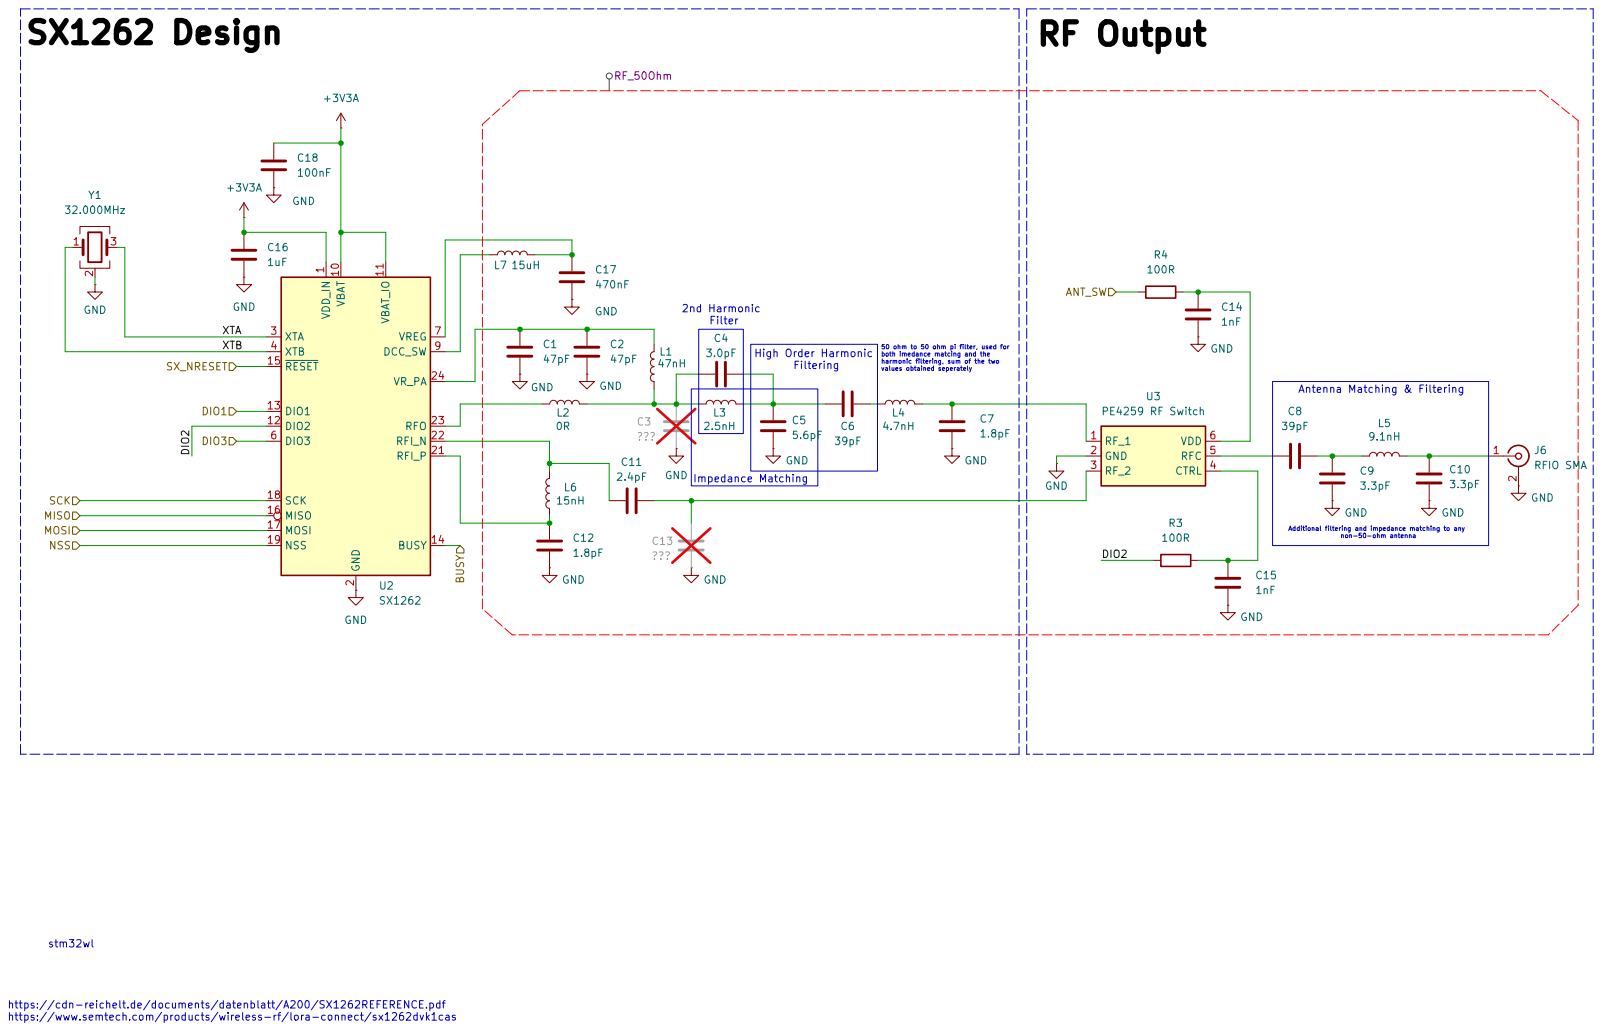
[picture p41: page 4]

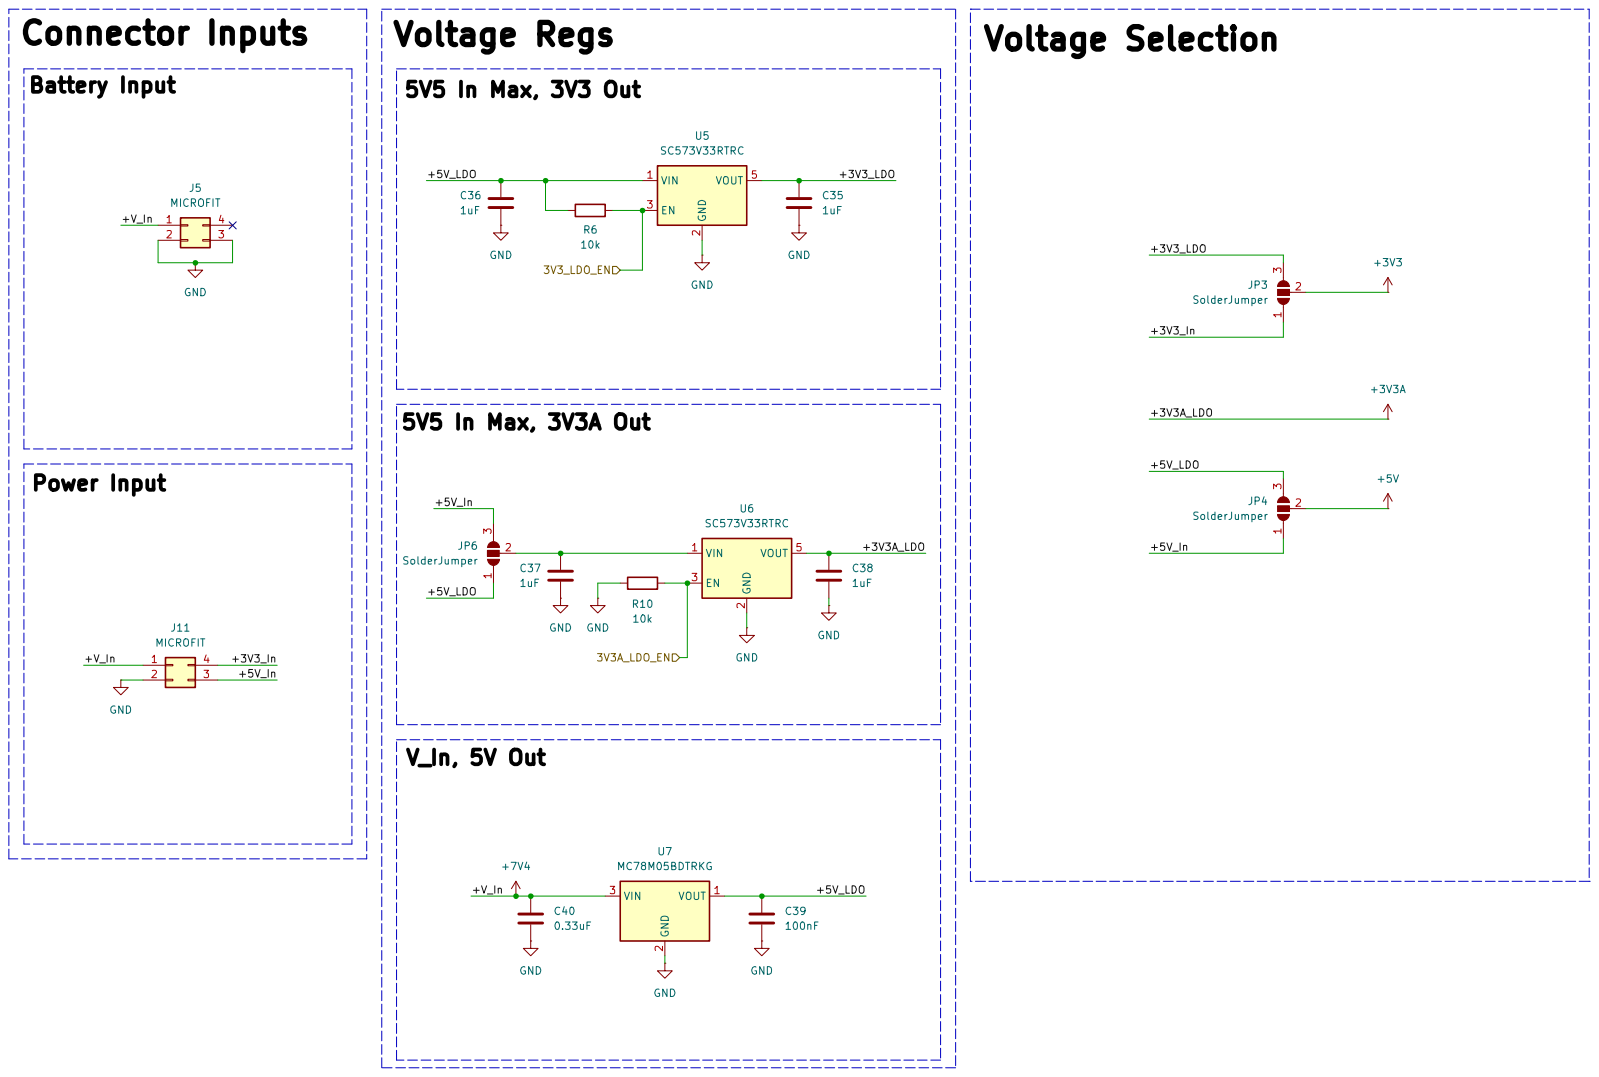
[picture p42: page 5]
