UC-Aerospace/Hybrid26_Radio/02 Rocket/Boards/Onboard_Radio/rf_rocket_module.kicad_pcb

## KiCad design 02 Rocket/Boards/Onboard_Radio/rf_rocket_module.kicad_pcb (2026-08-16)

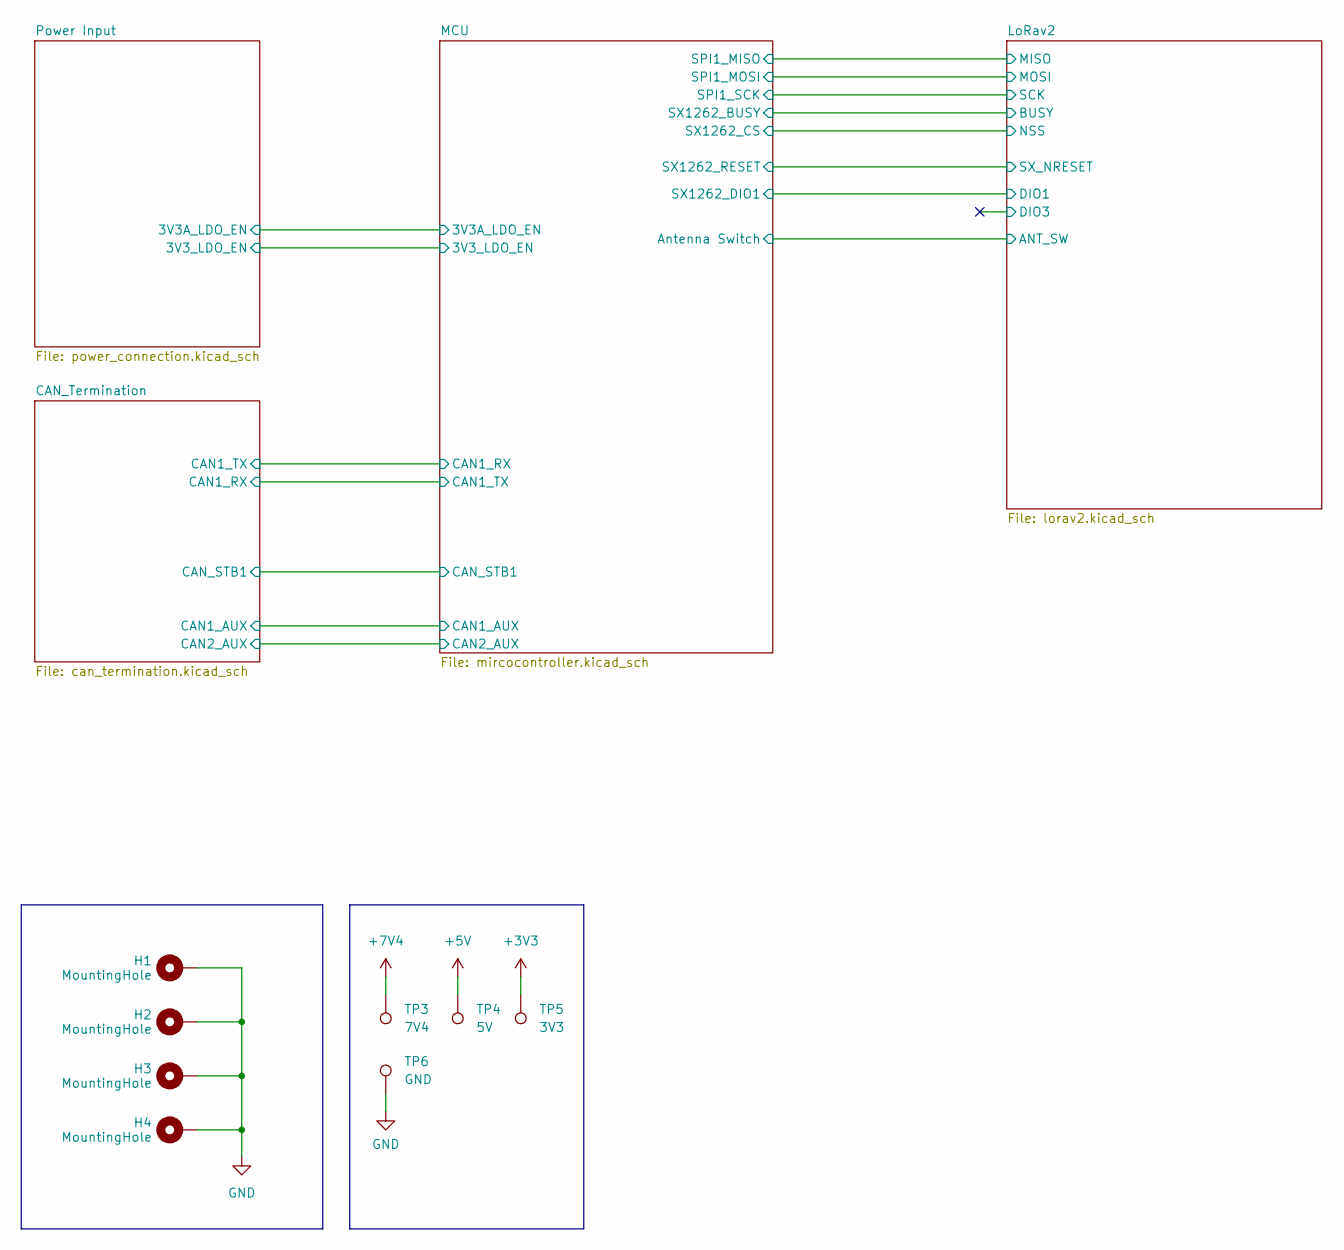
[picture p43: schematic rf_rocket_module.kicad_sch, Onboard Radio]

Parts:
H1, H2, H3, H4: MountingHole; MountingHole_3.2mm_M3_DIN965_Pad
TP3: 7V4; TestPoint_Pad_1.0x1.0mm
TP4: 5V; TestPoint_Pad_1.0x1.0mm
TP5: 3V3; TestPoint_Pad_1.0x1.0mm
TP6: GND; TestPoint_Pad_1.0x1.0mm

Connections:
GND: H1.1 (1_1), H2.1 (1_1), H3.1 (1_1), H4.1 (1_1), TP6.1; also elsewhere on the board

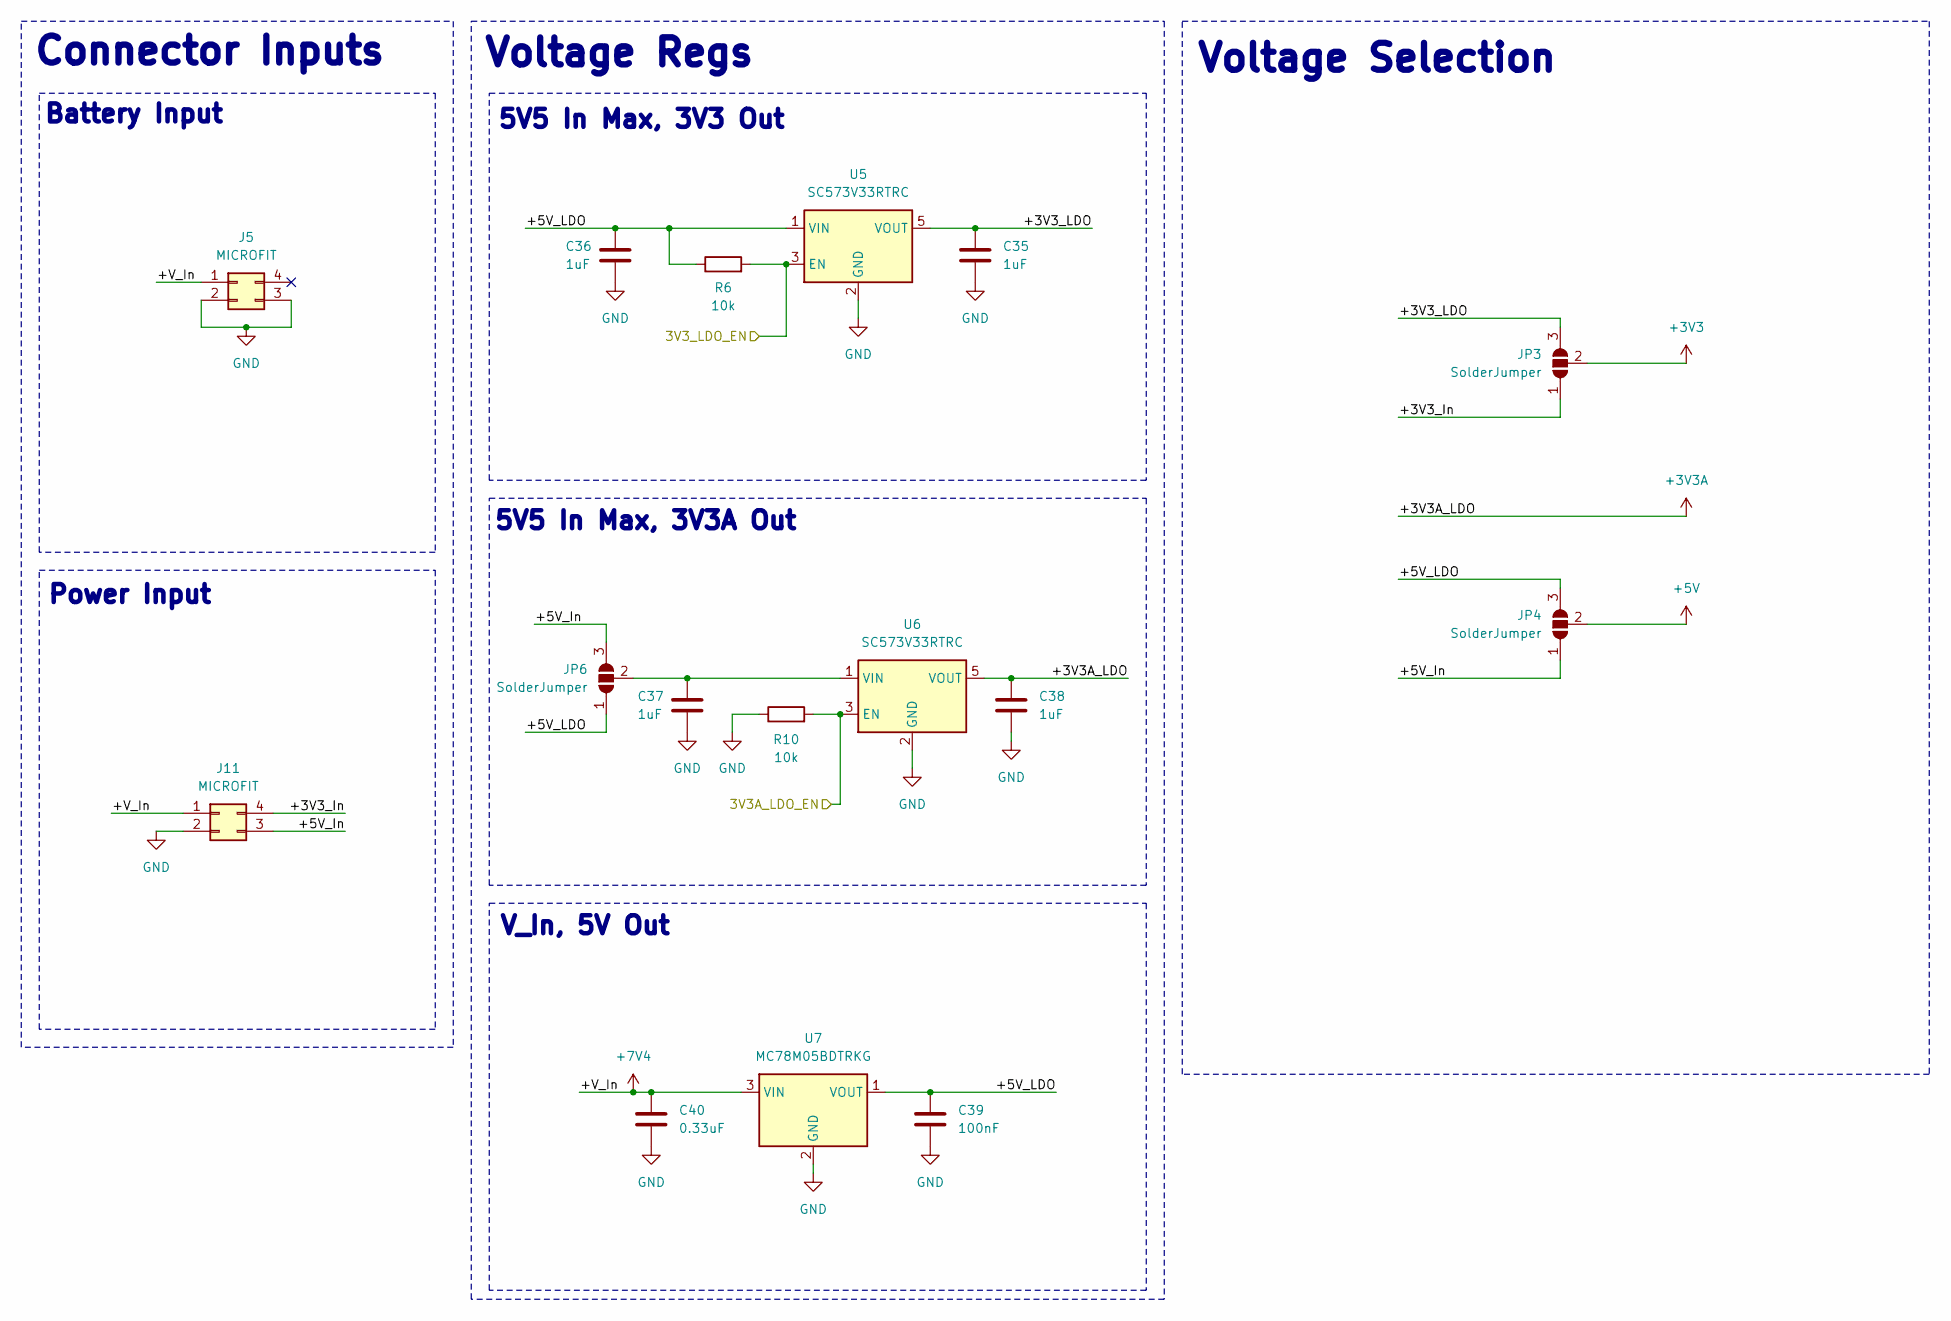
[picture p44: schematic power_connection.kicad_sch, Power Input]

Parts:
C35, C36, C37, C38: 1uF; C_0603_1608Metric; Voltage 10V; MPN GCM033C71A104KE02J; LCSC Part # C20041637
C39: 100nF; C_0603_1608Metric; Voltage 100V; MPN CL10E104KC8VPNC; LCSC Part # C16194197
C40: 0.33uF; C_0603_1608Metric; Voltage 50v; MPN CGA3E3X7R1H334K080AB; LCSC Part # C2178511
J5, J11: MICROFIT; Molex_Micro-Fit_3.0_43045-0412_2x02_P3.00mm_Vertical; MPN 0430450412; LCSC Part # C277721
JP3, JP4, JP6: SolderJumper; SolderJumper-3_P1.3mm_Open_RoundedPad1.0x1.5mm
R6, R10: 10k; R_0603_1608Metric; MPN RC0603FR-0710KL; LCSC Part # RC0603FR-0710KL
U5, U6: SC573V33RTRC; SOT-353_SC-70-5; MPN SC573V33RTRC; LCSC Part # C3751903
U7: MC78M05BDTRKG; TO-252-3_TabPin2; MPN MC78M05BDTRKG

Connections:
+3V3: JP3.2 (C); also elsewhere on the board
+3V3A: C38.1, U6.5 (VOUT); also elsewhere on the board
+5V: JP4.2 (C); also elsewhere on the board
+7V4: C40.1, J5.1, J11.1, U7.3 (VIN); also elsewhere on the board
/MCU/3V3A_LDO_EN: R10.2, U6.3 (EN); also elsewhere on the board
/MCU/3V3_LDO_EN: R6.2, U5.3 (EN); also elsewhere on the board
/Power Input/+3V3_In: J11.4, JP3.1 (A)
/Power Input/+3V3_LDO: C35.1, JP3.3 (B), U5.5 (VOUT)
/Power Input/+5V_In: J11.3, JP4.1 (A), JP6.3 (B)
/Power Input/+5V_LDO: C36.1, C39.1, JP4.3 (B), JP6.1 (A), R6.1, U5.1 (VIN), U7.1 (VOUT)
GND: C35.2, C36.2, C37.2, C38.2, C39.2, C40.2, J5.2, J5.3, J11.2, R10.1, U5.2 (GND), U6.2 (GND), U7.2 (GND); also elsewhere on the board
unnamed: C37.1, JP6.2 (C), U6.1 (VIN)

Notes on the sheet:
V_In, 5V Out
Voltage Regs
5V5 In Max, 3V3A Out
5V5 In Max, 3V3 Out
Voltage Selection
Connector Inputs
Power Input
Battery Input

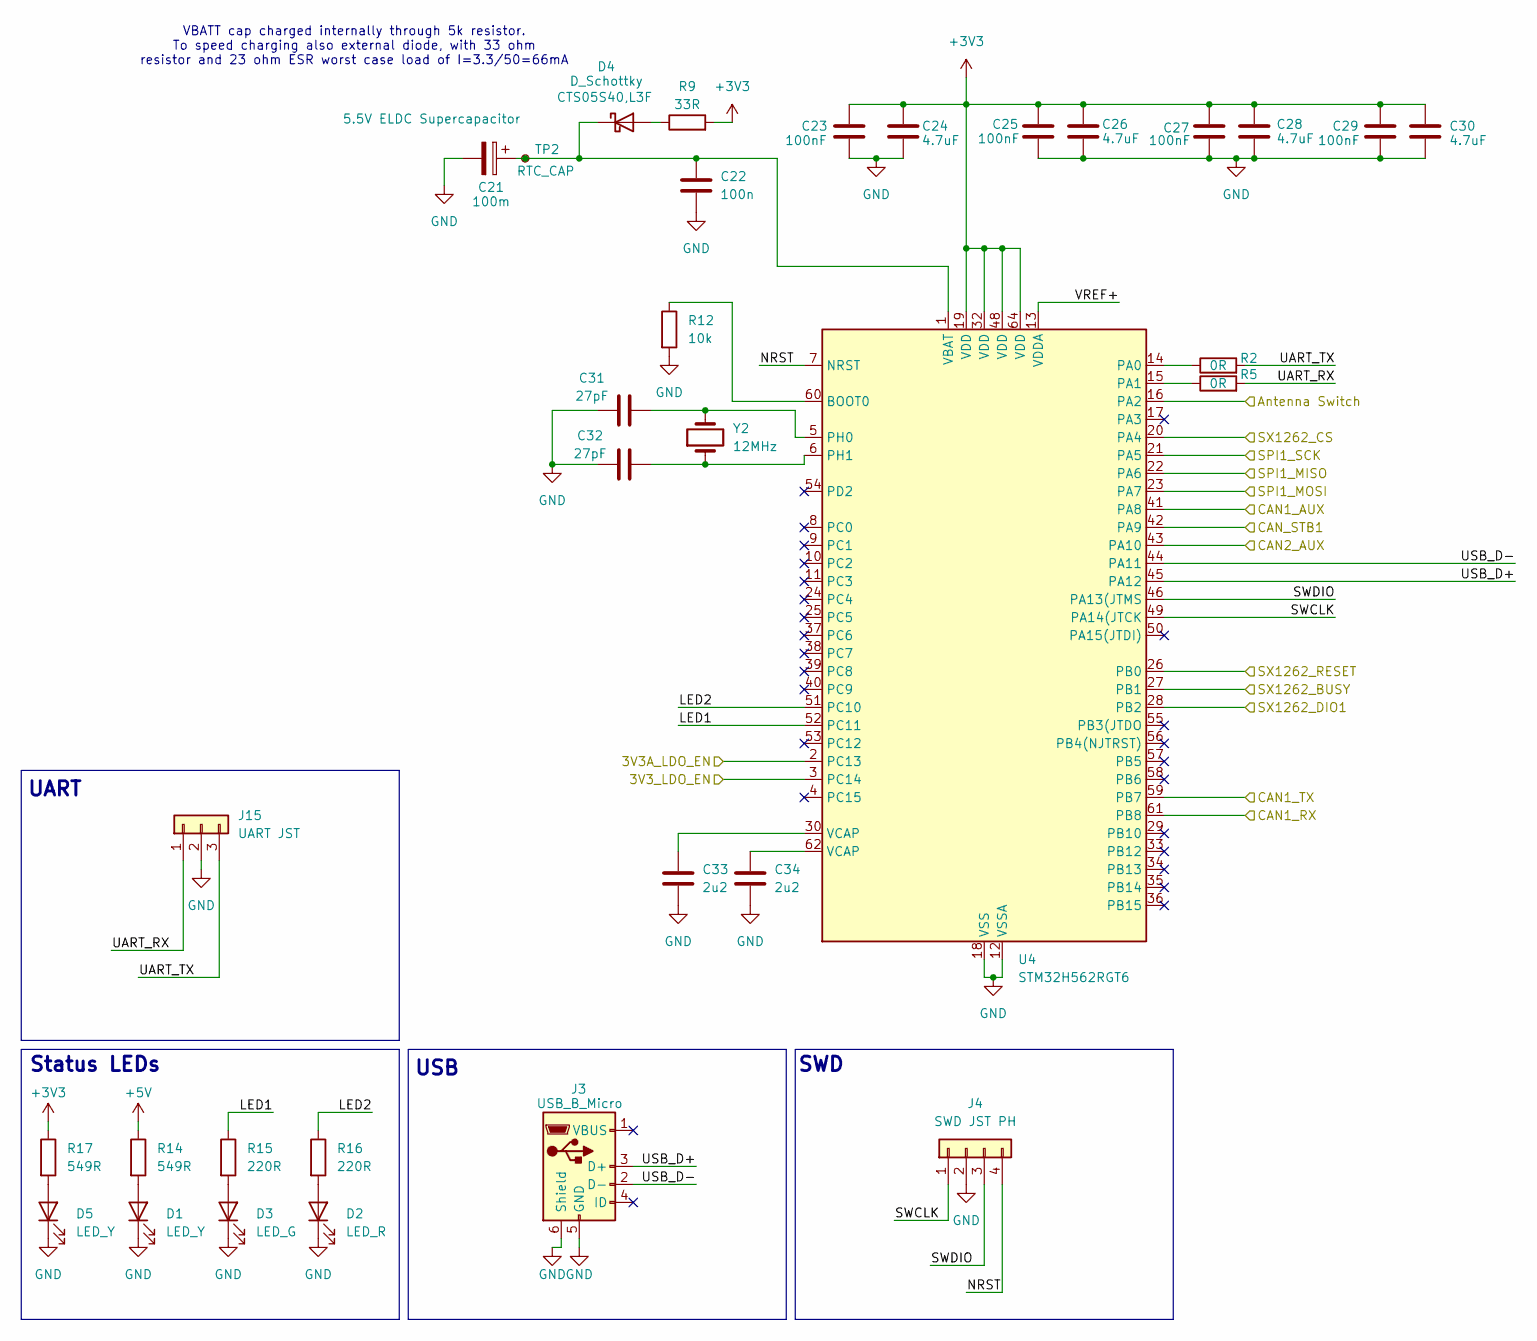
[picture p45: schematic mircocontroller.kicad_sch, Radio Microcontroller]

Parts:
C21: 100m; CP_Radial_D14.0mm_P5.00mm; MPN RSCBN1045R5G07014T
C22: 100n; C_0402_1005Metric; Voltage 50V; MPN KAM05FR71H104KH
C23, C25, C27, C29: 100nF; C_0603_1608Metric; Voltage 100V; MPN CL10E104KC8VPNC; LCSC Part # C16194197
C24, C26, C28, C30: 4.7uF; C_0603_1608Metric; Voltage 25V; MPN GRT188C81E475KE13D; LCSC Part # C907917
C31, C32: 27pF; C_0603_1608Metric; MPN GCM1885C2A270JA16D; LCSC Part # C909846
C33, C34: 2u2; R_0603_1608Metric; Voltage 25V; MPN GRM188R61E225KA12D; LCSC Part # C77047
D1, D5: LED_Y; LED_0603_1608Metric; MPN TLMY1100-GS15; LCSC Part # C20433848
D2: LED_R; LED_0603_1608Metric; MPN TLMS1000-GS15; LCSC Part # C23070302
D3: LED_G; LED_0603_1608Metric; MPN TLMG1100-GS15; LCSC Part # C20433785
D4: D_Schottky; D_SOD-882; MPN CTS05S40,L3F; LCSC Part # C396063
J3: USB_B_Micro; USB_Micro-B_Amphenol_10118193-0001LF_Horizontal; Voltage 100V; MPN 10118193-0001LF; LCSC Part # C132562
J4: SWD JST PH; JST_PH_B4B-PH-K_1x04_P2.00mm_Vertical; Voltage 100V; MPN B4B-PH-K-S; LCSC Part # C131334
J15: UART JST; JST_PH_B3B-PH-K_1x03_P2.00mm_Vertical; MPN B3B-PH-K-S
R2, R5: 0R; R_0402_1005Metric; MPN CRCW04020000Z0ED; LCSC Part # C190119
R9: 33R; R_0603_1608Metric; MPN RC0201FR-0733RL; LCSC Part # C295794
R12: 10k; R_0603_1608Metric; MPN RC0603FR-0710KL; LCSC Part # RC0603FR-0710KL
R14, R17: 549R; R_0603_1608Metric; MPN RMCF0603FT549R; LCSC Part # C4237517
R15, R16: 220R; R_0603_1608Metric; MPN RMCF0603JT220R; LCSC Part # C2484076
TP2: RTC_CAP; TestPoint_Pad_1.0x1.0mm
U4: STM32H562RGT6; LQFP-64_10x10mm_P0.5mm; MPN STM32H562RGT6; LCSC Part # C19711662
Y2: 12MHz; Crystal_SMD_Abracon_ABM8G-4Pin_3.2x2.5mm; MPN ABM8G-12.000MHZ-18-D2Y-T

Connections:
+3V3: C23.1, C24.1, C25.1, C26.1, C27.1, C28.1, C29.1, C30.1, R9.2, R17.1, U4.19 (VDD), U4.32 (VDD), U4.48 (VDD), U4.64 (VDD); also elsewhere on the board
+5V: R14.1; also elsewhere on the board
/CAN_Termination/CAN1_AUX: U4.41 (PA8); also elsewhere on the board
/CAN_Termination/CAN1_RX: U4.59 (PB7); also elsewhere on the board
/CAN_Termination/CAN1_TX: U4.61 (PB8); also elsewhere on the board
/CAN_Termination/CAN2_AUX: U4.43 (PA10); also elsewhere on the board
/CAN_Termination/CAN_STB1: U4.42 (PA9); also elsewhere on the board
/LoRav2/ANT_SW: U4.16 (PA2); also elsewhere on the board
/LoRav2/BUSY: U4.27 (PB1); also elsewhere on the board
/LoRav2/DIO1: U4.28 (PB2); also elsewhere on the board
/LoRav2/MISO: U4.22 (PA6); also elsewhere on the board
/LoRav2/MOSI: U4.23 (PA7); also elsewhere on the board
/LoRav2/NSS: U4.20 (PA4); also elsewhere on the board
/LoRav2/SCK: U4.21 (PA5); also elsewhere on the board
/LoRav2/SX_NRESET: U4.26 (PB0); also elsewhere on the board
/MCU/3V3A_LDO_EN: U4.2 (PC13); also elsewhere on the board
/MCU/3V3_LDO_EN: U4.3 (PC14); also elsewhere on the board
/MCU/LED1: R15.1, U4.52 (PC11)
/MCU/LED2: R16.1, U4.51 (PC10)
/MCU/NRST: J4.4, U4.7 (NRST)
/MCU/SWCLK: J4.1, U4.49 (PA14(JTCK)
/MCU/SWDIO: J4.3, U4.46 (PA13(JTMS)
/MCU/UART_RX: J15.1, R5.2
/MCU/UART_TX: J15.3, R2.2
/MCU/USB_D+: J3.3 (D+), U4.45 (PA12)
/MCU/USB_D-: J3.2 (D-), U4.44 (PA11)
/MCU/VREF+: U4.13 (VDDA)
GND: C21.2, C22.2, C23.2, C24.2, C25.2, C26.2, C27.2, C28.2, C29.2, C30.2, C31.1, C32.2, C33.2, C34.2, D1.1 (K), D2.1 (K), D3.1 (K), D5.1 (K), J3.5 (GND), J3.6 (Shield), J4.2, J15.2, R12.2, U4.12 (VSSA), U4.18 (VSS), U4.31 (VSS), U4.47 (VSS), U4.63 (VSS); also elsewhere on the board
unnamed: C33.1, U4.30 (VCAP)
unnamed: C34.1, U4.62 (VCAP)
unnamed: D1.2 (A), R14.2
unnamed: D2.2 (A), R16.2
unnamed: D3.2 (A), R15.2
unnamed: D4.2 (A), R9.1
unnamed: C21.1, C22.1, D4.1 (K), TP2.1, U4.1 (VBAT)
unnamed: D5.2 (A), R17.2
unnamed: R12.1, U4.60 (BOOT0)
unnamed: R2.1, U4.14 (PA0)
unnamed: R5.1, U4.15 (PA1)
unnamed: C31.2, U4.5 (PH0), Y2.3 (2)
unnamed: C32.1, U4.6 (PH1), Y2.1

Notes on the sheet:
VBATT cap charged internally through 5k resistor. To speed charging also external diode, with 33 ohm resistor and 23 ohm ESR worst case load of I=3.3/50=66mA
SWD
UART
USB
Status LEDs

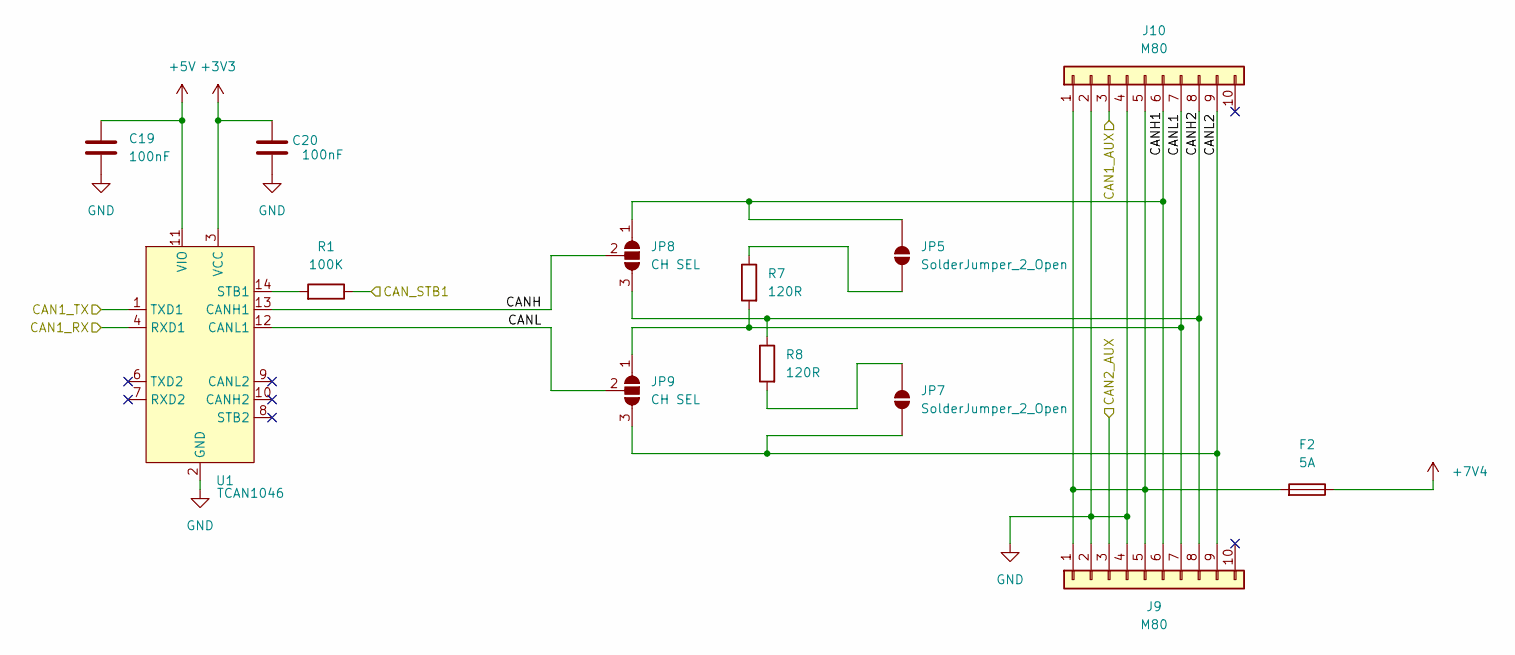
[picture p46: schematic can_termination.kicad_sch, CAN Transceiver]

Parts:
C19, C20: 100nF; C_0603_1608Metric; Voltage 100V; MPN CL10E104KC8VPNC; LCSC Part # C16194197
F2: 5A; Fuse_1206_3216Metric; Voltage 63V; MPN C1F 5; LCSC Part # C3166463
J9, J10: M80; HARWIN_M80-5011005; MPN M80-5301042; LCSC Part # C17382082
JP5, JP7: SolderJumper_2_Open; SolderJumper-2_P1.3mm_Open_RoundedPad1.0x1.5mm
JP8, JP9: CH SEL; SolderJumper-3_P1.3mm_Open_RoundedPad1.0x1.5mm
R1: 100K; R_0603_1608Metric; MPN RMCF0603FT100K; LCSC Part # C237792
R7, R8: 120R; R_0603_1608Metric; MPN RMCF0603JT120R; LCSC Part # C3995226
U1: TCAN1046; Texas_DYY0014A_TSOT-23-14; MPN TCAN1046AVDYYRQ1; LCSC Part # C3233845

Connections:
+3V3: C20.1, U1.3 (VCC); also elsewhere on the board
+5V: C19.1, U1.11 (VIO); also elsewhere on the board
+7V4: F2.1; also elsewhere on the board
/CAN_Termination/CAN1_AUX: J10.3; also elsewhere on the board
/CAN_Termination/CAN1_RX: U1.4 (RXD1); also elsewhere on the board
/CAN_Termination/CAN1_TX: U1.1 (TXD1); also elsewhere on the board
/CAN_Termination/CAN2_AUX: J9.3; also elsewhere on the board
/CAN_Termination/CANH: JP8.2 (C), U1.13 (CANH1)
/CAN_Termination/CANH1: J9.6, J10.6, JP5.2 (B), JP8.1 (A)
/CAN_Termination/CANH2: J9.8, J10.8, JP8.3 (B), R8.1
/CAN_Termination/CANL: JP9.2 (C), U1.12 (CANL1)
/CAN_Termination/CANL1: J9.7, J10.7, JP9.1 (A), R7.2
/CAN_Termination/CANL2: J9.9, J10.9, JP7.1 (A), JP9.3 (B)
/CAN_Termination/CAN_STB1: R1.1; also elsewhere on the board
GND: C19.2, C20.2, J9.2, J9.4, J10.2, J10.4, U1.2 (GND), U1.5 (GND); also elsewhere on the board
unnamed: F2.2, J9.1, J9.5, J10.1, J10.5
unnamed: JP5.1 (A), R7.1
unnamed: JP7.2 (B), R8.2
unnamed: R1.2, U1.14 (STB1)

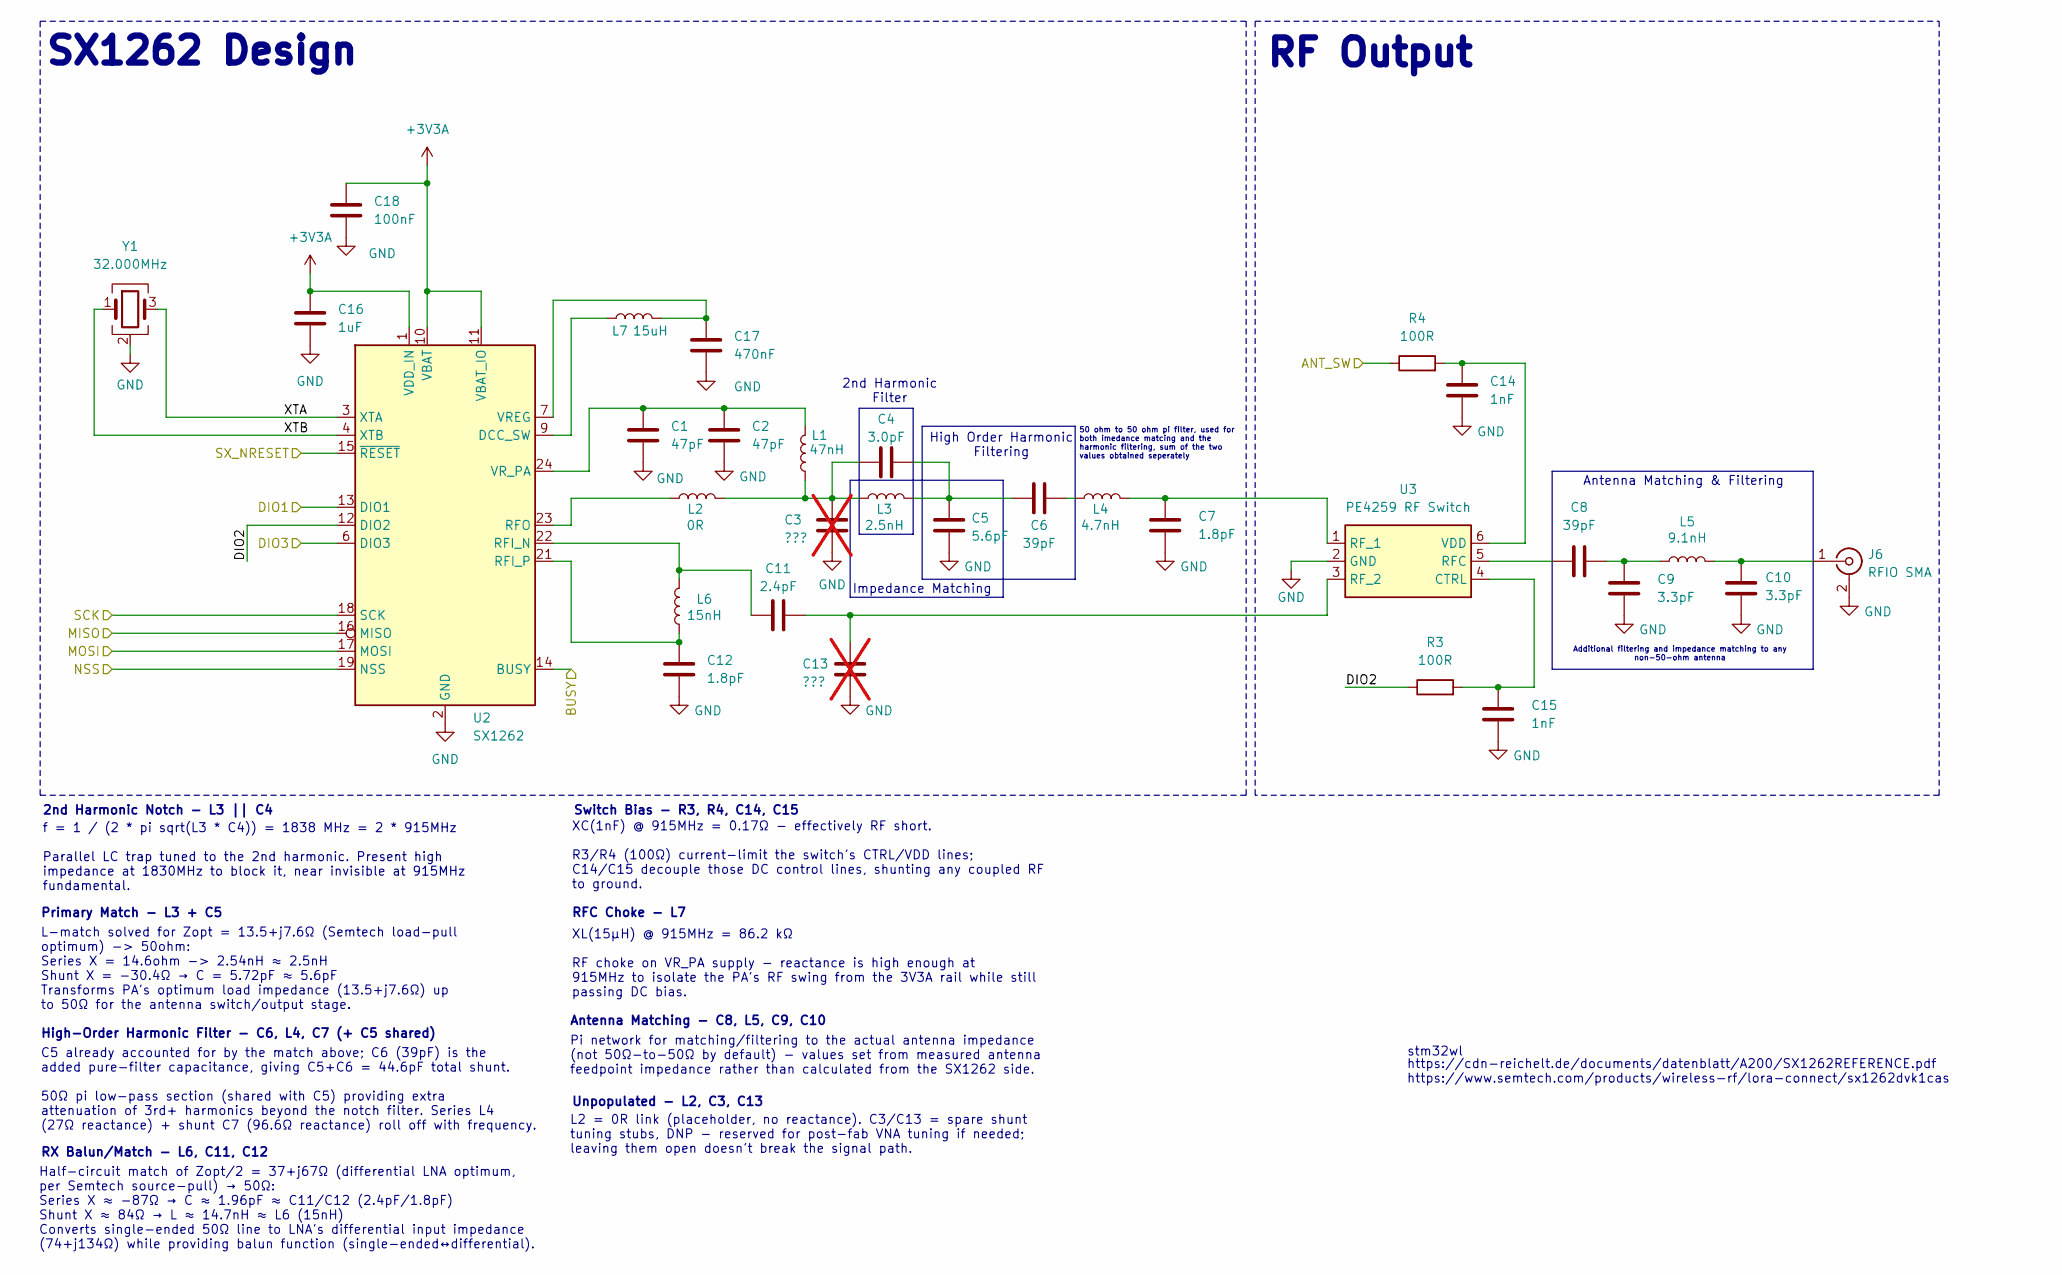
[picture p47: schematic lorav2.kicad_sch, Radio IC]

Parts:
C1, C2: 47pF; C_0402_1005Metric; Voltage 50V; MPN GJM1555C1H470JB01D; LCSC Part # C161322
C3, C13: ???; C_0402_1005Metric; not fitted
C4: 3.0pF; C_0402_1005Metric; Voltage 50V; MPN GJM1555C1H3R0BB01D; LCSC Part # C88891
C5: 5.6pF; C_0402_1005Metric; Voltage 50V; MPN GJM1555C1H5R6CB01D; LCSC Part # C88895
C6, C8: 39pF; C_0402_1005Metric; Voltage 50V; MPN GJM1555C1H390JB01D; LCSC Part # C426038
C7, C12: 1.8pF; C_0402_1005Metric; Voltage 50V; MPN GJM1555C1H1R8BB01D; LCSC Part # C76902
C9, C10: 3.3pF; C_0402_1005Metric; Voltage 50V; MPN GJM1555C1H3R3BB01D; LCSC Part # C76906
C11: 2.4pF; C_0402_1005Metric; Voltage 50V; MPN GJM1555C1H2R4BB01D; LCSC Part # C88888
C14, C15: 1nF; C_0402_1005Metric; Voltage 100V; MPN GRM155R72A102KA01D; LCSC Part # C162197
C16: 1uF; C_0402_1005Metric; Voltage 16V; MPN GRM155R61C105KA12D; LCSC Part # C77006
C17: 470nF; C_0402_1005Metric; Voltage 10V; MPN GRM155R71A474KE01D; LCSC Part # C88946
C18: 100nF; C_0402_1005Metric; Voltage 50V; MPN GRM155R71H104KE14D; LCSC Part # C77020
J6: RFIO SMA; SMA-KE-16.5A_EdgeMount; MPN 142-0701-841; LCSC Part # C3173357
L1: 47nH; L_0402_1005Metric; MPN LQW15AN47NJ00D; LCSC Part # C192855
L2: 0R; R_0402_1005Metric; MPN CRCW04020000Z0ED; LCSC Part # C190119
L3: 2.5nH; L_0402_1005Metric; MPN LQW15AN2N5C00D; LCSC Part # C703121
L4: 4.7nH; L_0402_1005Metric; MPN LQW15AN4N7C00D; LCSC Part # C167480
L5: 9.1nH; L_0402_1005Metric; MPN LQW15AN9N1H00D; LCSC Part # C337956
L6: 15nH; L_0402_1005Metric; MPN LQW15AN15NH00D; LCSC Part # C91621
L7: 15uH; L_0805_2012Metric; MPN MLZ2012M150WT000; LCSC Part # C383402
R3, R4: 100R; R_0402_1005Metric; MPN CRCW0402100RFKED; LCSC Part # C82865
U2: SX1262; QFN-24-1EP_4x4mm_P0.5mm_EP2.6x2.6mm; MPN SX1262IMLTRT; LCSC Part # C191341
U3: PE4259 RF Switch; SOT-363_SC-70-6; MPN 4259-63; LCSC Part # C470892
Y1: 32.000MHz; Oscillator_SMD_ECS_2520MV-xxx-xx-4Pin_2.5x2.0mm; MPN TYETBCSANF-32.000000

Connections:
+3V3A: C16.1, C18.1, U2.1 (VDD_IN), U2.10 (VBAT), U2.11 (VBAT_IO); also elsewhere on the board
/LoRav2/ANT_SW: R4.1; also elsewhere on the board
/LoRav2/BUSY: U2.14 (BUSY); also elsewhere on the board
/LoRav2/DIO1: U2.13 (DIO1); also elsewhere on the board
/LoRav2/DIO2: R3.1, U2.12 (DIO2)
/LoRav2/DIO3: U2.6 (DIO3)
/LoRav2/MISO: U2.16 (MISO); also elsewhere on the board
/LoRav2/MOSI: U2.17 (MOSI); also elsewhere on the board
/LoRav2/NSS: U2.19 (NSS); also elsewhere on the board
/LoRav2/SCK: U2.18 (SCK); also elsewhere on the board
/LoRav2/SX_NRESET: U2.15 (~RESET); also elsewhere on the board
/LoRav2/XTA: U2.3 (XTA), Y1.3
/LoRav2/XTB: U2.4 (XTB), Y1.1
GND: C1.2, C2.2, C3.2, C5.2, C7.2, C9.2, C10.2, C12.2, C13.2, C14.2, C15.2, C16.2, C17.2, C18.2, J6.2 (Ext), U2.2 (GND), U2.5 (GND), U2.8 (GND), U2.20 (GND), U2.25 (GND), U3.2 (GND), Y1.2 (G), Y1.4 (G); also elsewhere on the board
unnamed: C3.1, C4.1, L1.1, L2.2, L3.1
unnamed: C4.2, C5.1, C6.1, L3.2
unnamed: C6.2, L4.1
unnamed: C8.2, C9.1, L5.1
unnamed: C10.1, J6.1 (In), L5.2
unnamed: L7.1, U2.9 (DCC_SW)
unnamed: C11.1, L6.2, U2.22 (RFI_N)
unnamed: C12.1, L6.1, U2.21 (RFI_P)
unnamed: L2.1, U2.23 (RFO)
unnamed: C17.1, L7.2, U2.7 (VREG)
unnamed: C1.1, C2.1, L1.2, U2.24 (VR_PA)
unnamed: C15.1, R3.2, U3.4 (CTRL)
unnamed: C8.1, U3.5 (RFC)
unnamed: C7.1, L4.2, U3.1 (RF_1)
unnamed: C11.2, C13.1, U3.3 (RF_2)
unnamed: C14.1, R4.2, U3.6 (VDD)

Notes on the sheet:
Additional filtering and impedance matching to any non-50-ohm antenna
C5 already accounted for by the match above; C6 (39pF) is the added pure-filter capacitance, giving C5+C6 = 44.6pF total shunt. 50Ω pi low-pass section (shared with C5) providing extra attenuation of 3rd+ harmonics beyond the notch filter. Series L4 (27Ω reactance) + shunt C7 (96.6Ω reactance) roll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
https://cdn-reichelt.de/documents/datenblatt/A200/SX1262REFERENCE.pdf https://www.semtech.com/products/wireless-rf/lora-connect/sx1262dvk1cas
Impedance Matching
Primary Match - L3 + C5
Pi network for matching/filtering to the actual antenna impedance (not 50Ω-to-50Ω by default) - values set from measured antenna feedpoint impedance rather than calculated from the SX1262 side.
High-Order Harmonic Filter - C6, L4, C7 (+ C5 shared)
RX Balun/Match - L6, C11, C12
L-match solved for Zopt = 13.5+j7.6Ω (Semtech load-pull optimum) -> 50ohm: Series X = 14.6ohm -> 2.54nH ≈ 2.5nH Shunt X = -30.4Ω → C = 5.72pF ≈ 5.6pF Transforms PA's optimum load impedance (13.5+j7.6Ω) up to 50Ω for the antenna switch/output stage.
Half-circuit match of Zopt/2 = 37+j67Ω (differential LNA optimum, per Semtech source-pull) → 50Ω: Series X ≈ −87Ω → C ≈ 1.96pF ≈ C11/C12 (2.4pF/1.8pF) Shunt X ≈ 84Ω → L ≈ 14.7nH ≈ L6 (15nH) Converts single-ended 50Ω line to LNA's differential input impedance (74+j134Ω) while providing balun functio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
Antenna Matching - C8, L5, C9, C10
Unpopulated - L2, C3, C13
RFC Choke - L7
2nd Harmonic Notch - L3 || C4
f = 1 / (2 * pi sqrt(L3 * C4)) = 1838 MHz = 2 * 915MHz Parallel LC trap tuned to the 2nd harmonic. Present high impedance at 1830MHz to block it, near invisible at 915MHz fundamental.
stm32wl
Antenna Matching & Filtering
High Order Harmonic Filtering
SX1262 Design
RF Output
50 ohm to 50 ohm pi filter, used for both imedance matcing and the harmonic filtering, sum of the two values obtained seperately
2nd Harmonic Filter
XL(15µH) @ 915MHz = 86.2 kΩ RF choke on VR_PA supply - reactance is high enough at 915MHz to isolate the PA's RF swing from the 3V3A rail while still passing DC bias.
Switch Bias - R3, R4, C14, C15
XC(1nF) @ 915MHz = 0.17Ω - effectively RF short. R3/R4 (100Ω) current-limit the switch's CTRL/VDD lines; C14/C15 decouple those DC control lines, shunting any coupled RF to ground.
L2 = 0R link (placeholder, no reactance). C3/C13 = spare shunt tuning stubs, DNP - reserved for post-fab VNA tuning if needed; leaving them open doesn't break the signal path.

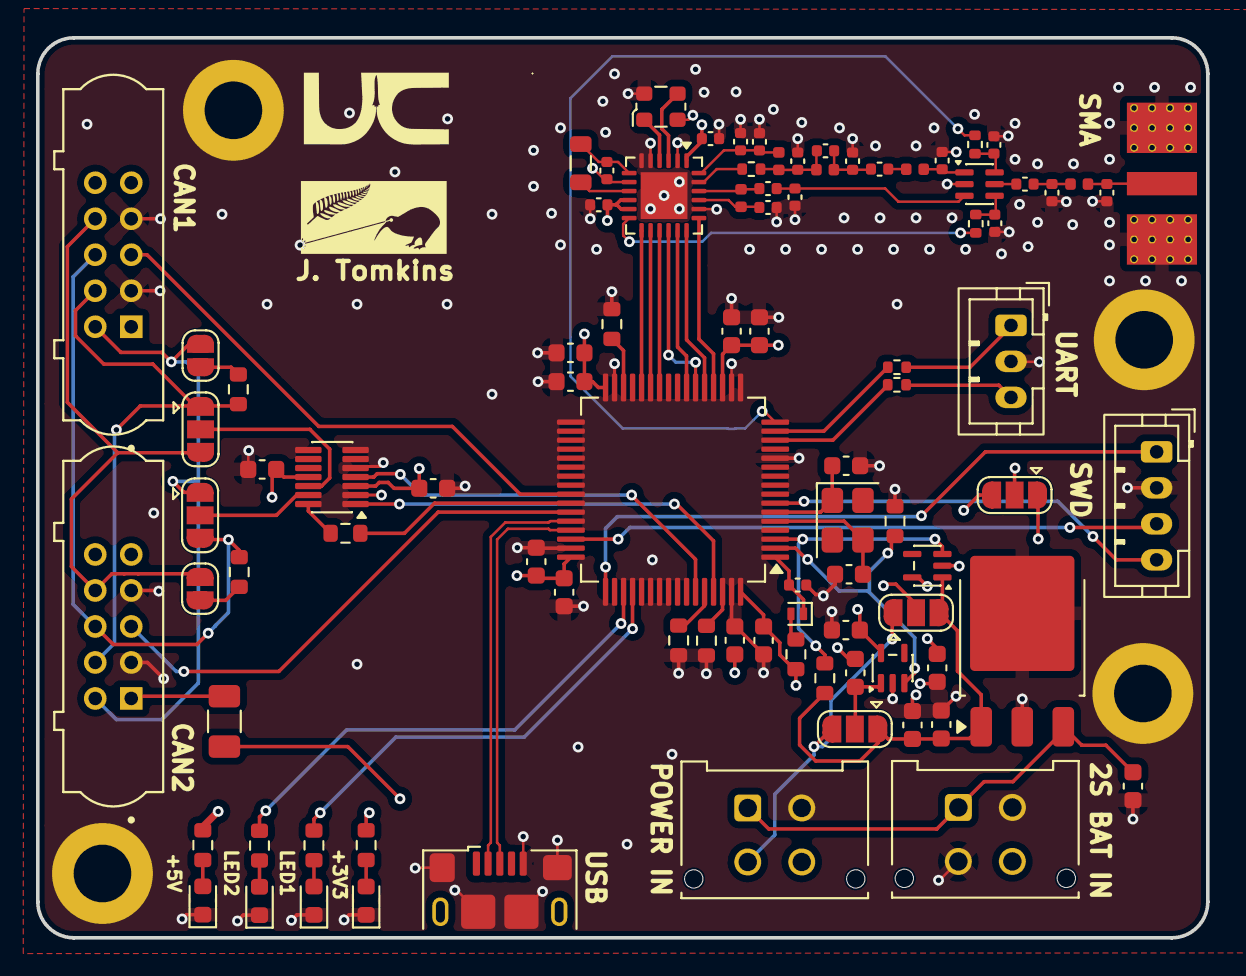
[picture p48: board 02 Rocket/Boards/Onboard_Radio/rf_rocket_module.kicad_pcb from above]

Board: 4 copper layers, 65.0 x 50.0 mm, 95 parts (0 on the bottom side), 76 nets.
