UC-Aerospace/Hybrid26_Radio/03 Ground Station/Boards/GS_Radio/_restore_backup_2026-05-20T13-01-22-586/rf_rocket_module.kicad_pcb

## KiCad design 03 Ground Station/Boards/GS_Radio/_restore_backup_2026-05-20T13-01-22-586/rf_rocket_module.kicad_pcb (2026-05-20)

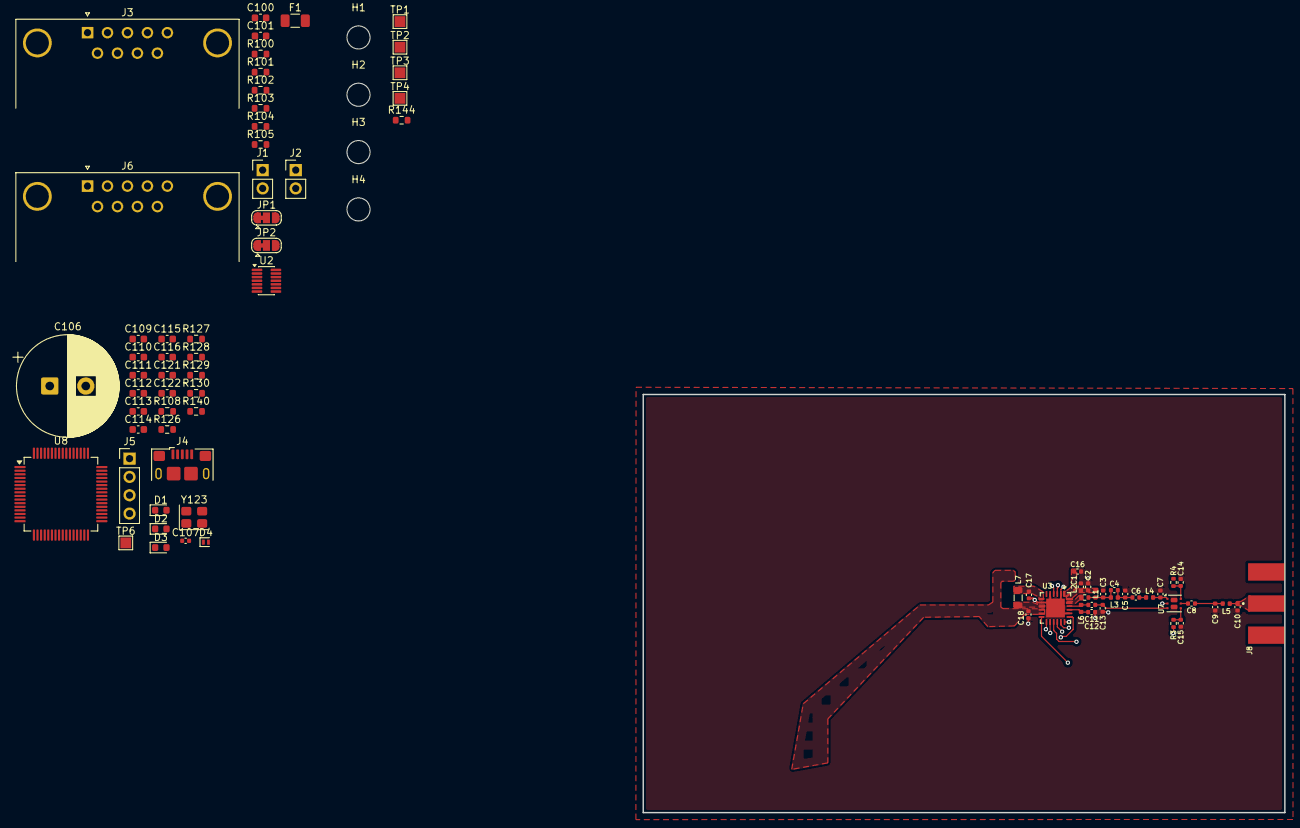
[picture p49: board 03 Ground Station/Boards/GS_Radio/_restore_backup_2026-05-20T13-01-22… from above]

Board: 4 copper layers, 89.0 x 58.0 mm, 83 parts (0 on the bottom side), 53 nets.

Parts:
C1, C2: 47pF; C_0402_1005Metric
C3, C13: ???; C_0402_1005Metric
C4: 3.0pF; C_0402_1005Metric
C5: 5.6pF; C_0402_1005Metric
C6, C8: 39pF; C_0402_1005Metric
C7, C12: 1.8pF; C_0402_1005Metric
C9, C10: 3.3pF; C_0402_1005Metric
C11: 2.4pF; C_0402_1005Metric
C14, C15: 1nF; C_0402_1005Metric
C16: 1uF; C_0402_1005Metric
C17: 470nF; C_0402_1005Metric
C18: 100nF; C_0402_1005Metric
C100, C101, C109, C110, C113, C115: 100nF; C_0603_1608Metric
C106: 100m; CP_Radial_D14.0mm_P5.00mm
C107: 100n; C_0402_1005Metric
C111, C112, C114, C116: 4.7uF; C_0603_1608Metric
C121, C122: 27pF; C_0603_1608Metric
D1: LED_Y; LED_0603_1608Metric
D2: LED_G; LED_0603_1608Metric
D3: LED_R; LED_0603_1608Metric
D4: D_Schottky; D_SOD-882
F1: 5A; Fuse_1206_3216Metric
H1, H2, H3, H4: MountingHole; MountingHole_3.2mm_M3
J1: CAN1_T; PinHeader_1x02_P2.54mm_Vertical
J2: CAN2_T; PinHeader_1x02_P2.54mm_Vertical
J3, J6: DB9 Microfit; DSUB-9_Pins_Horizontal_P2.77x2.84mm_EdgePinOffset7.70mm_Hou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
J4: USB_B_Micro; USB_Micro-B_Amphenol_10118193-0001LF_Horizontal
J5: SWD JST PH; PinHeader_1x04_P2.54mm_Vertical
J8: RFIO SMA; JOHNSON_142-0701-841
JP1, JP2: CH SEL; SolderJumper-3_P1.3mm_Bridged12_RoundedPad1.0x1.5mm
L1: 47nH; L_0402_1005Metric
L2: 0R; R_0402_1005Metric
L3: 2.5nH; L_0402_1005Metric
L4: 4.7nH; L_0402_1005Metric
L5: 9.1nH; L_0402_1005Metric
L6: 15nH; L_0402_1005Metric
L7: 15uH; L_0805_2012Metric
R3, R4: 100R; R_0402_1005Metric
R100, R101, R102, R103: 100K; R_0603_1608Metric
R104, R105: 120R; R_0603_1608Metric
R108: 33R; R_0603_1608Metric
R126: 549R; R_0603_1608Metric
R127, R128: 220R; R_0603_1608Metric
R129: R; R_0603_1608Metric
R130, R140: 27R; R_0603_1608Metric
R144: 0R; R_0603_1608Metric
TP1: 7V4; TestPoint_Pad_1.5x1.5mm
TP2: 5V; TestPoint_Pad_1.5x1.5mm
TP3: 3V3; TestPoint_Pad_1.5x1.5mm
TP4: GND; TestPoint_Pad_1.5x1.5mm
TP6: RTC_CAP; TestPoint_Pad_1.5x1.5mm
U2: TCAN1046; Texas_DYY0014A_TSOT-23-14
U3: SX1262; QFN-24-1EP_4x4mm_P0.5mm_EP2.6x2.6mm
U7: PE4259 RF Switch; Vishay_PowerPAK_SC70-6L_Dual
U8: STM32H562RGT6; LQFP-64_10x10mm_P0.5mm
Y123: 12MHz; Crystal_SMD_Abracon_ABM8G-4Pin_3.2x2.5mm

Connections:
+3V3: C101.1, C109.1, C110.1, C111.1, C112.1, C113.1, C114.1, C115.1, C116.1, R100.1, R101.2, R102.2, R103.1, R108.2, R129.1, TP3.1 (1_1), U2.3 (VCC)
+5V: C100.1, TP2.1 (1_1), U2.11 (VIO)
+7V4: F1.1, R126.1, R144.2, TP1.1 (1_1)
/CAN_Termination/CAN1_RX: U2.4 (RXD1), U8.61 (PB8)
/CAN_Termination/CAN1_TX: U2.1 (TXD1), U8.59 (PB7)
/CAN_Termination/CANH: JP1.2 (C), U2.13 (CANH1)
/CAN_Termination/CANH1: J1.1, J3.6, J6.6, JP1.1 (A)
/CAN_Termination/CANH2: J3.8, J6.8, JP1.3 (B), R105.1
/CAN_Termination/CANL: JP2.2 (C), U2.12 (CANL1)
/CAN_Termination/CANL1: J3.7, J6.7, JP2.1 (A), R104.2
/CAN_Termination/CANL2: J2.1, J3.9, J6.9, JP2.3 (B)
/LoRav2/DIO2: R3.1, U3.12 (DIO2)
/MCU/LED1: R127.1, U8.9 (PC1)
/MCU/LED2: R128.1, U8.10 (PC2)
/MCU/NRST: J5.4, R129.2, U8.7 (NRST)
/MCU/SWCLK: J5.1, U8.46 (PA13(JTMS)
/MCU/SWDIO: J5.3, U8.49 (PA14(JTCK)
/MCU/USB_D+: J4.3 (D+), R140.2
/MCU/USB_D-: J4.2 (D-), R130.1
GND: C1.2, C2.2, C3.2, C5.2, C7.2, C9.2, C10.2, C12.2, C13.2, C14.2, C15.2, C16.2, C17.2, C18.2, C100.2, C101.2, C106.2, C107.2, C109.2, C110.2, C111.2, C112.2, C113.2, C114.2, C115.2, C116.2, C121.1, C122.2, D1.1 (K), D2.1 (K), D3.1 (K), J3.2, J3.4, J4.5 (GND), J5.2, J6.2, J6.4, TP4.1 (1_1), U2.2 (GND), U2.5 (GND), U3.2 (GND), U3.5 (GND), U3.8 (GND), U3.20 (GND), U3.25 (GND), U7.2 (GND), U8.12 (VSSA), U8.18 (VSS), U8.19 (VDD), U8.31 (VSS), U8.32 (VDD), U8.47 (VSS), U8.48 (VDD), U8.63 (VSS), U8.64 (VDD)
unnamed: C3.1, C4.1, L1.1, L2.2, L3.1
unnamed: C4.2, C5.1, C6.1, L3.2
unnamed: C6.2, L4.1
unnamed: C8.2, C9.1, L5.1
unnamed: D1.2 (A), R126.2
unnamed: D2.2 (A), R127.2
unnamed: D3.2 (A), R128.2
unnamed: D4.2 (A), R108.1
unnamed: C106.1, C107.1, D4.1 (K), TP6.1 (1_1), U8.1 (VBAT)
unnamed: F1.2, J3.1, J3.5, J6.1, J6.5
unnamed: J1.2, R104.1
unnamed: J2.2, R105.2
unnamed: C10.1, J8.1 (In_1), L5.2
unnamed: R102.1, U2.7 (RXD2)
unnamed: R100.2, U2.14 (STB1)
unnamed: R103.2, U2.8 (STB2)
unnamed: R101.1, U2.6 (TXD2)
unnamed: L7.1, U3.9 (DCC_SW)
unnamed: C11.1, L6.2, U3.22 (RFI_N)
unnamed: C12.1, L6.1, U3.21 (RFI_P)
unnamed: L2.1, U3.23 (RFO)
unnamed: C17.1, L7.2, U3.7 (VREG)
unnamed: C1.1, C2.1, L1.2, U3.24 (VR_PA)
unnamed: C15.1, R3.2, U7.4 (CTRL)
unnamed: C8.1, U7.5 (RFC)
unnamed: C7.1, L4.2, U7.1 (RF_1)
unnamed: C11.2, C13.1, U7.3 (RF_2)
unnamed: C14.1, R4.2, U7.6 (VDD)
unnamed: R130.2, U8.44 (PA11)
unnamed: R140.1, U8.45 (PA12)
unnamed: C121.2, U8.5 (PH0), Y123.2
unnamed: C122.1, U8.6 (PH1), Y123.1
VDD_RADIO: C16.1, C18.1, U3.1 (VDD_IN), U3.10 (VBAT), U3.11 (VBAT_IO)
