UC-Aerospace/Hybrid26_Radio/02 Rocket/Code/Core/Src/main.c

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
/* Includes ------------------------------------------------------------------*/
#include "main.h"

/* USER CODE BEGIN Includes */
#include "scheduler.h"
#include "log.h"
#include "usb_cdc.h"
#include "radio.h"
// #include "can_bus.h"
#include "radio_test.h"
// #include "can_radio_bridge.h"
// #include <stdio.h>
/* USER CODE END Includes */

/* USER CODE BEGIN PD */
#define ROLE_ROCKET 0
#define ROLE_GROUND 1

/* Set to ROLE_ROCKET for the onboard/rocket board (forwards every received
 * CAN frame over the radio, verbatim) or ROLE_GROUND for the ground station
 * (listens continuously and logs received packets over UART4). Only used by
 * bring-up STAGE 4 below. */
#define BOARD_ROLE ROLE_ROCKET
/* USER CODE END PD */


SPI_HandleTypeDef hspi1;

UART_HandleTypeDef huart4;

PCD_HandleTypeDef hpcd_USB_DRD_FS;

void SystemClock_Config(void);
static void MPU_Config(void);
static void MX_GPIO_Init(void);
static void MX_ICACHE_Init(void);
static void MX_SPI1_Init(void);
static void MX_USB_PCD_Init(void);
static void MX_UART4_Init(void);
/* USER CODE BEGIN PFP */
#if BOARD_ROLE == ROLE_GROUND
static void GroundStation_Task(void);
#endif
/* USER CODE END PFP */

/* USER CODE BEGIN 0 */
#if BOARD_ROLE == ROLE_GROUND
static void GroundStation_Task(void)
{
    if (!Radio_IsBusy())
    {
        Radio_StartReceive();
    }
}
#endif

/* Bring-up helpers for STAGE 1 and STAGE 3 below (see USER CODE 2). Each is
 * only referenced from inside its own commented-out stage block, so expect
 * a harmless "defined but not used" warning while that stage is inactive. */
static uint32_t s_stage1_counter = 0;

static void Stage1_UartTask(void)
{
    Log_Printf("[%lu] STAGE1 UART OK count=%lu\r\n", HAL_GetTick(), s_stage1_counter++);
}

// static void Stage3_CanLogTask(void)
// {
//     CanBus_Message_t msg;
//
//     while (CanBus_GetReceived(&msg))
//     {
//         char hex[3 * CANBUS_MAX_DATA_LEN + 1];
//         size_t pos = 0;
//
//         for (uint8_t i = 0; i < msg.len; i++)
//         {
//             pos += (size_t)snprintf(hex + pos, sizeof(hex) - pos, "%02X ", msg.data[i]);
//         }
//         Log_Printf("[%lu] STAGE3 CAN id=0x%lX len=%u data=%s\r\n", HAL_GetTick(), msg.id, msg.len, hex);
//     }
// }
/* USER CODE END 0 */

/**
  * @brief  The application entry point.
  * @retval int
  */
int main(void)
{

  /* MCU Configuration--------------------------------------------------------*/

  /* MPU Configuration--------------------------------------------------------*/
  MPU_Config();

  /* Reset of all peripherals, Initializes the Flash interface and the Systick. */
  HAL_Init();

  /* Configure the system clock */
  SystemClock_Config();

  /* Initialize all configured peripherals */
  MX_GPIO_Init();
  MX_ICACHE_Init();
  MX_SPI1_Init();
  MX_USB_PCD_Init();
  MX_UART4_Init();
  /* USER CODE BEGIN 2 */
  /* Defensive re-assert: guarantee the analog 3V3 LDO stays disabled and
   * the digital 3V3 LDO stays enabled at startup, regardless of what runs
   * before this point. */
  HAL_GPIO_WritePin(A3V3_LDO_EN_GPIO_Port, A3V3_LDO_EN_Pin, GPIO_PIN_RESET);
  HAL_GPIO_WritePin(D3V3_LDO_EN_GPIO_Port, D3V3_LDO_EN_Pin, GPIO_PIN_SET);

  Scheduler_Init();

  /* TinyUSB owns the USB_DRD_FS peripheral registers directly (see the
   * comment in MX_USB_PCD_Init), so it's initialized here instead of via
   * HAL_PCD_Init. UsbCdc_Task must run often for the port to enumerate and
   * stay responsive; 1 ms is what a full-speed CDC port needs. */
  UsbCdc_Init();
  Scheduler_AddTask(UsbCdc_Task, 1);

  /* ------------------------------------------------------------------
   * BRING-UP TEST STAGES
   *
   * Each stage below has a description comment (leave it alone) and,
   * right under it, its own short comment-wrapped code block. Delete
   * just that inner pair of comment markers to activate one stage's
   * code, build, flash, and verify it before moving to the next stage.
   * Each stage assumes the previous one already works. Re-comment a
   * stage's code before activating the next one's. Leave all of them
   * commented out and nothing runs; stage 4 is also where production
   * behavior lives.
   * ------------------------------------------------------------------ */

  /* ---- STAGE 1: UART4 / Log_Printf sanity check --------------------
   * No radio, no CAN. Confirms Log_Printf() reaches your terminal or
   * radio_dashboard.py at all. Expect one "STAGE1 UART OK count=..."
   * line per second.
   * -------------------------------------------------------------- */
  Scheduler_AddTask(Stage1_UartTask, 1000);

  /* ---- STAGE 2: Radio heartbeat (SPI + SX1262) ---------------------
   * Confirms the SPI link and SX1262 bring-up in isolation: transmits
   * an incrementing counter every 50 ms. Watch for "RADIO TX" /
   * "RADIO TXDONE" lines (and "RADIO RX" on the receiving board, if
   * it's also running and in range).
   * -------------------------------------------------------------- */
  Radio_Init();
  RadioTest_Init();
  Scheduler_AddTask(Radio_Task, 5);
  Scheduler_AddTask(RadioTest_Task, 50);

  /* ---- STAGE 3: CAN bus sanity check --------------------------------
   * No radio. Confirms FDCAN1 + TCAN1046 bring-up: logs every CAN
   * frame received as "STAGE3 CAN id=... len=... data=...".
   * -------------------------------------------------------------- */
  /*
  CanBus_Init();
  Scheduler_AddTask(CanBus_Task, 5);
  Scheduler_AddTask(Stage3_CanLogTask, 5);
  */

  /* ---- STAGE 4: Full bridge (production behavior) -------------------
   * The real rocket/ground logic, exactly as shipped. Set BOARD_ROLE
   * above to ROLE_ROCKET or ROLE_GROUND before uncommenting this.
   * -------------------------------------------------------------- */
  /*
  Radio_Init();
  CanBus_Init();
  Scheduler_AddTask(Radio_Task, 5);
  Scheduler_AddTask(CanBus_Task, 5);
#if BOARD_ROLE == ROLE_ROCKET
  Scheduler_AddTask(CanRadioBridge_Task, 5);
#else
  Radio_StartReceive();
  Scheduler_AddTask(GroundStation_Task, 5);
#endif
  */
  /* USER CODE END 2 */

  /* Infinite loop */
  /* USER CODE BEGIN WHILE */
  while (1)
  {
    /* USER CODE END WHILE */

    /* USER CODE BEGIN 3 */
    Scheduler_Run();
  }
  /* USER CODE END 3 */
}

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
 /* MPU Configuration */

void MPU_Config(void)
{
  MPU_Region_InitTypeDef MPU_InitStruct = {0};
  MPU_Attributes_InitTypeDef MPU_AttributesInit = {0};

  /* Disables the MPU */
  HAL_MPU_Disable();

  /** Initializes and configures the Region 0 and the memory to be protected
  */
  MPU_InitStruct.Enable = MPU_REGION_ENABLE;
  MPU_InitStruct.Number = MPU_REGION_NUMBER0;
  MPU_InitStruct.BaseAddress = 0x08FFF000;
  MPU_InitStruct.LimitAddress = 0x08FFFFFF;
  MPU_InitStruct.AttributesIndex = MPU_ATTRIBUTES_NUMBER0;
  MPU_InitStruct.AccessPermission = MPU_REGION_ALL_RO;
  MPU_InitStruct.DisableExec = MPU_INSTRUCTION_ACCESS_DISABLE;
  MPU_InitStruct.IsShareable = MPU_ACCESS_NOT_SHAREABLE;

  HAL_MPU_ConfigRegion(&MPU_InitStruct);

  /** Initializes and configures the Attribute 0 and the memory to be protected
  */
  MPU_AttributesInit.Number = MPU_ATTRIBUTES_NUMBER0;
  MPU_AttributesInit.Attributes = INNER_OUTER(MPU_NOT_CACHEABLE);

  HAL_MPU_ConfigMemoryAttributes(&MPU_AttributesInit);
  /* Enables the MPU */
  HAL_MPU_Enable(MPU_PRIVILEGED_DEFAULT);

}

/**
  * @brief  This function is executed in case of error occurrence.
  * @param None
  * @retval None
  */
void Error_Handler(void)
{
  /* USER CODE BEGIN Error_Handler_Debug */
  /* User can add his own implementation to report the HAL error return state */
  __disable_irq();
  while (1)
  {
  }
  /* USER CODE END Error_Handler_Debug */
}
#ifdef USE_FULL_ASSERT
/**
  * @brief  Reports the name of the source file and the source line number
  *         where the assert_param error has occurred.
  * @param  file: pointer to the source file name
  * @param  line: assert_param error line source number
  * @retval None
  */
void assert_failed(uint8_t *file, uint32_t line)
{
  /* USER CODE BEGIN 6 */
  /* User can add his own implementation to report the file name and line number,
     ex: printf("Wrong parameters value: file %s on line %d\r\n", file, line) */
  /* USER CODE END 6 */
}
#endif /* USE_FULL_ASSERT */
