UC-Aerospace/Hybrid26_Radio/03 Ground Station/HybridRadio17082026/HybridRadio17082026.ioc

Mcu.UserName=STM32H562RGTx
PA0.Signal=UART4_TX
PA1.Signal=UART4_RX
PA11.Signal=USB_DM
PA12.Signal=USB_DP
PA2.GPIO_Label=ANT_SW
PA2.Signal=GPIO_Output
PA4.GPIO_Label=SX1262_CS
PA4.Signal=GPIO_Output
PA5.Signal=SPI1_SCK
PA6.Signal=SPI1_MISO
PA7.Signal=SPI1_MOSI
PB0.GPIO_Label=SX1262_RESET
PB0.Signal=GPIO_Output
PB1.GPIO_Label=SX1262_BUSY
PB1.Signal=GPIO_Input
PB2.GPIO_Label=SX1262_DIO1
PB2.Signal=GPIO_Input
PC10.GPIO_Label=LED2
PC10.Signal=GPIO_Output
PC11.GPIO_Label=LED1
PC11.Signal=GPIO_Output
PC13.GPIO_Label=LDO_3V3A_EN
PC13.Signal=GPIO_Output
PC14-OSC32_IN(OSC32_IN).GPIO_Label=LDO_3V3D_EN
PC14-OSC32_IN(OSC32_IN).Signal=GPIO_Output
PH0-OSC_IN(PH0).Signal=RCC_OSC_IN
PH1-OSC_OUT(PH1).Signal=RCC_OSC_OUT
