UC-Aerospace/Hybrid26_Radio/02 Rocket/Code/Core/Inc/log.h

#ifndef LOG_H
#define LOG_H

#ifdef __cplusplus
extern "C" {
#endif

/* Blocking, formatted debug log over UART4 (115200 8N1), mirrored
 * non-blockingly to the native USB CDC virtual COM port (see usb_cdc.h) --
 * whichever one a host has open will show the output. Include a
 * terminating "\r\n" in fmt yourself. */
void Log_Printf(const char *fmt, ...);

#ifdef __cplusplus
}
#endif

#endif /* LOG_H */
