UC-Aerospace/Hybrid26_Radio/(commit log)

2026-04-29 python sim code added
    [rf_rocket_module.kicad_sch]
2026-05-19 rf chip schematic changed
    [antenna.kicad_sch, can_termination.kicad_sch, lora_module.kicad_sch, lorav2.kicad_sch, mircocontroller.kicad_sch, power_connection.kicad_sch, power_input.kicad_sch, rf_rocket_module.kicad_sch]
2026-05-20 schematic bom needs updating and traces need finishing
    [antenna.kicad_sch, can_termination.kicad_sch, lora_module.kicad_sch, lorav2.kicad_sch, mircocontroller.kicad_sch, power_connection.kicad_sch, power_input.kicad_sch, rf_rocket_module.kicad_pcb]
2026-05-20 pcb done, need schematic review
    [lorav2.kicad_sch, mircocontroller.kicad_sch, rf_rocket_module.kicad_pcb, rf_rocket_module.kicad_sch]
2026-05-20 need to finish bom
    [can_termination.kicad_sch, lorav2.kicad_sch, mircocontroller.kicad_sch, power_connection.kicad_sch, rf_rocket_module.kicad_sch]
2026-05-28 can bus updeated
    [can_termination.kicad_sch, lorav2.kicad_sch, mircocontroller.kicad_sch, power_connection.kicad_sch, rf_rocket_module.kicad_sch]
2026-05-28 pcb updates
    [can_termination.kicad_sch, rf_rocket_module.kicad_pcb]
2026-05-28 post narottam meetup
    [lorav2.kicad_sch, rf_rocket_module.kicad_pcb]
2026-06-02 jpole project created
    [JPole_Antenna.kicad_pcb, JPole_Antenna.kicad_sch, rf_rocket_module.kicad_pcb]
2026-06-03 jpole needs review
    [JPole_Antenna.kicad_pcb]
2026-06-03 radio ic board planes joined, pcb made smaller, need to add cantraces before review
    [lorav2.kicad_sch, mircocontroller.kicad_sch, rf_rocket_module.kicad_pcb, rf_rocket_module.kicad_sch]
2026-06-03 schematic ready for review
    [can_termination.kicad_sch, lorav2.kicad_sch, mircocontroller.kicad_sch, rf_rocket_module.kicad_pcb, rf_rocket_module.kicad_sch]
2026-06-16 everything minus trace impedance and via stictching
    [can_termination.kicad_sch, lorav2.kicad_sch, mircocontroller.kicad_sch, power_connection.kicad_sch, rf_rocket_module.kicad_pcb, rf_rocket_module.kicad_sch]
2026-06-16 rf traces updated, need to workout board net class
    [lorav2.kicad_sch, rf_rocket_module.kicad_pcb]
2026-06-16 via fencing done, need via stiching
    [lorav2.kicad_sch, rf_rocket_module.kicad_pcb]
2026-06-17 needs pcb and schematic review
    [bom.csv, can_termination.kicad_sch, designators.csv, lorav2.kicad_sch, mircocontroller.kicad_sch, positions.csv, power_connection.kicad_sch, rf_rocket_module.kicad_pcb]
2026-06-17 updated swd and crystal
    [mircocontroller.kicad_sch, rf_rocket_module.kicad_pcb, rf_rocket_module.kicad_sch]
2026-06-17 jpole updates, ready for review
    [JPole_Antenna.kicad_sch]
2026-06-18 ground station pcb and schematic created and updated
    [Ground_station_board.kicad_pcb, Ground_station_board.kicad_sch, lorav2.kicad_sch, mircocontroller.kicad_sch, power_connection.kicad_sch, rf_rocket_module.kicad_pcb]
2026-06-18 via stitching added to gs board, need fencing before review
    [Ground_station_board.kicad_pcb, mircocontroller.kicad_sch]
2026-06-18 file system update
    [Ground_station_board.kicad_pcb, Ground_station_board.kicad_sch, JPole_Antenna.kicad_pcb, JPole_Antenna.kicad_sch, antenna.kicad_sch, bom.csv, can_termination.kicad_sch, designators.csv]
2026-06-19 idk aye
    [Ground_station_board.kicad_pcb, Ground_station_board.kicad_sch, JPole_Antenna.kicad_pcb, antenna.kicad_sch, bom.csv, can_termination.kicad_sch, designators.csv, jpoleboard.step]
2026-06-19 rocket, gs, jpole need review b4 order, update last of bom
    [mircocontroller.kicad_sch, power_connection.kicad_sch, rf_rocket_module.kicad_pcb]
2026-06-22 Narottam Updates Resolved
    [JPole_Antenna.kicad_pcb, can_termination.kicad_sch, lorav2.kicad_sch, mircocontroller.kicad_sch, power_connection.kicad_sch, rf_rocket_module.kicad_pcb, rf_rocket_module.kicad_sch]
2026-06-25 radio board ordered!
    [bom.csv, can_termination.kicad_sch, designators.csv, lorav2.kicad_sch, mircocontroller.kicad_sch, positions.csv, power_connection.kicad_sch, rf_rocket_module.kicad_pcb]
2026-07-22 updates to schematic notes
    [JPole_Antenna.kicad_pcb, bom.csv, lorav2.kicad_sch, positions.csv, rf_rocket_module.csv]
2026-08-06 changed to including in stages
2026-08-16 stripped back rocket code
    [rf_rocket_module.kicad_pcb]
2026-08-24 Add radio.c/radio.h and STM32 SPI/USB HAL drivers to rocket and ground station projects
    Sync main.c, radio.c, and HAL MSP changes across both boards; add missing
    SPI/PCD/USB LL driver sources needed by the ground station build.
    [HybridRadio17082026.ioc, main.c, main.h, radio.c, radio.h]
