UC-Aerospace/Hybrid26_Radio/(notices)

Notices in the files:
02 Rocket/Code/Core/Src/main.c:
Copyright (c) 2026 STMicroelectronics.
All rights reserved.
This software is licensed under terms that can be found in the LICENSE file
